Sinis16/Atlas/Tesis Electronica.xlsx

Sheet: BI Timeline
Task | Completion | Detailed task | Beginning week | End week | Perc | perc
Component investigation | 100.00 | 1.1 Processor | 2025-01-13 | 2025-01-20 | 100%
Component investigation | 100.00 | 1.2 PMIC (Power management) | 2025-01-13 | 2025-01-20 | 100%
Component investigation | 100.00 | 1.3 UWB Component | 2025-01-13 | 2025-01-20 | 100%
Component investigation | 100.00 | 1.4Wireless Charging Component | 2025-01-13 | 2025-01-20 | 100%
Component investigation | 100.00 | 1.5 NFC Component | 2025-01-13 | 2025-01-20 | 100%
Technology investigation | 100.00 | 2.1 Firmware to use | 2025-01-13 | 2025-01-20 | 100%
Technology investigation | 100.00 | 2.2 Bluetooth Signal Receiving | 2025-01-20 | 2025-02-03 | 100%
Technology investigation | 100.00 | 2.3 Bluetooth programming | 2025-01-27 | 2025-02-17 | 100%
Technology investigation | 100.00 | 2.4 Bluetooth Antenna | 2025-01-13 | 2025-02-17 | 100%
Technology investigation | 100.00 | 2.5 UWB Signal Receiving | 2025-01-20 | 2025-02-03 | 100%
Technology investigation | 100.00 | 2.6 UWB programming | 2025-01-27 | 2025-02-17 | 100%
Technology investigation | 100.00 | 2.7 UWB Antenna | 2025-01-13 | 2025-02-03 | 40%
Technology investigation | 100.00 | 2.8 Wireless Charging Programming | 2025-01-27 | 2025-02-17 | 40%
Technology investigation | 100.00 | 2.9 Wireless Charging Antenna | 2025-01-13 | 2025-02-03 | 40%
Technology investigation | 100.00 | 2.10 NFC Signal Receiving | 2025-01-20 | 2025-02-03 | 40%
Technology investigation | 100.00 | 2.11 NFC Programming | 2025-01-27 | 2025-02-17 | 0%
Technology investigation | 100.00 | 2.12 NFC Antenna | 2025-01-13 | 2025-02-03 | 0%
Application investigation | 0.00 | 3.1 Software to make | 2025-02-10 | 2025-03-03 | 0%
Application investigation | 0.00 | 3.2 Database to use | 2025-02-17 | 2025-03-10 | 0%
Application investigation | 0.00 | 3.3 Data to store | 2025-02-17 | 2025-03-10 | 0%
Application investigation | 0.00 | 3.4 UI to elaborate | 2025-02-24 | 2025-03-17 | 0%
Technology exploration | 0.00 | 4.1 Processor module | 2025-02-10 | 2025-03-10 | 0%
Technology exploration | 0.00 | 4.2 Processor module + App | 2025-03-31 | 2025-04-21 | 0%
Technology exploration | 0.00 | 4.3 Processor module + Bluetooth | 2025-02-17 | 2025-02-24 | 0%
Technology exploration | 0.00 | 4.4 Processor module + UWB | 2025-02-24 | 2025-03-03 | 0%
Technology exploration | 0.00 | 4.5 Processor module + NFC | 2025-03-03 | 2025-03-10 | 0%
Technology exploration | 0.00 | 4.6 Processor module + Wireles Charging | 2025-03-10 | 2025-03-17 | 0%
Antenna design | 0.00 | 5.1 Bluetooth PCB Design | 2025-03-17 | 2025-03-24 | 0%
Antenna design | 0.00 | 5.2 UWB PCB Design | 2025-03-17 | 2025-03-24 | 0%
Antenna design | 0.00 | 5.3 NFC / Wireless charging Design | 2025-03-17 | 2025-03-24 | 0%
PCB design | 0.00 | 6.1 Processor and complementary passive | 2025-03-24 | 2025-04-07 | 0%
PCB design | 0.00 | 6.2 PMIC (Power management) | 2025-03-31 | 2025-04-14 | 0%
PCB design | 0.00 | 6.3 Wireless Charging | 2025-04-07 | 2025-04-14 | 0%
PCB design | 0.00 | 6.4 Application Design | 2025-02-17 | 2025-03-10 | 0%
PCB design | 0.00 | 6.5 Application Implementation | 2025-03-17 | 2025-05-12 | 0%
PCB trials | 0.00 | 6.1 Processor functionality | 2025-04-21 | 2025-05-12 | 0%
PCB trials | 0.00 | 6.2 Bluetooth functionality | 2025-04-21 | 2025-05-12 | 0%
PCB trials | 0.00 | 6.3 Bluetooth Specs | 2025-05-19 | 2025-05-26 | 0%
PCB trials | 0.00 | 6.4 UWB functionality | 2025-04-21 | 2025-05-12 | 0%
PCB trials | 0.00 | 6.5 UWB Specs | 2025-05-19 | 2025-05-26 | 0%
PCB trials | 0.00 | 6.6 Wireless Charging Functionality | 2025-04-21 | 2025-05-12 | 0%
PCB trials | 0.00 | 6.7 NFC Functionality | 2025-04-21 | 2025-05-12 | 0%
Documentation | 0.00 | 7.1 Document | 2025-01-27 | 2025-05-26 | 0%

Sheet: Timeline
Time |  | Mes | noviembre | noviembre | noviembre | noviembre | diciembre | diciembre | diciembre | diciembre | diciembre | enero | enero | enero | enero | febrero | febrero | febrero | febrero | marzo | marzo | marzo | marzo | marzo | abril | abril | abril | abril | mayo | mayo | mayo | mayo
 |  | Semana | 2024-11-04 | 2024-11-11 | 2024-11-18 | 2024-11-25 | 2024-12-02 | 2024-12-09 | 2024-12-16 | 2024-12-23 | 2024-12-30 | 2025-01-06 | 2025-01-13 | 2025-01-20 | 2025-01-27 | 2025-02-03 | 2025-02-10 | 2025-02-17 | 2025-02-24 | 2025-03-03 | 2025-03-10 | 2025-03-17 | 2025-03-24 | 2025-03-31 | 2025-04-07 | 2025-04-14 | 2025-04-21 | 2025-04-28 | 2025-05-05 | 2025-05-12 | 2025-05-19 | 2025-05-26
Period | Component investigation | Processor |  | Done
 |  | PMIC (Power management) |  | Done
 |  | UWB Component |  | Done
 |  | Wireless Charging Component |  | Done
 |  | NFC Component |  | Done
 | Technology investigation | Firmware to use
 |  | Bluetooth Signal Receiving |  |  | Bluetooth Signal Receiving
 |  | Bluetooth programming |  |  |  | Bluetooth programming
 |  | Bluetooth Antenna
 |  | UWB Signal Receiving |  |  | UWB Signal Receiving
 |  | UWB programming |  |  |  | UWB programming
 |  | UWB Antenna
 |  | Wireless Charging Programming |  |  |  | Wireless Charging Programming
 |  | Wireless Charging Antenna
 |  | NFC Signal Receiving |  |  | NFC Signal Receiving
 |  | NFC Programming |  |  |  | NFC Programming
 |  | NFC Antenna
 | Application investigation | Software to make |  |  |  |  |  |  |  | Software to make
 |  | Database to use |  |  |  |  |  |  |  |  | Database to use
 |  | Data to store |  |  |  |  |  |  |  |  | Data to store
 |  | UI to elaborate |  |  |  |  |  |  |  |  |  | UI to elaborate
 | Technology exploration | Processor module |  |  |  |  |  |  | Processor module
 |  | Processor module + App |  |  |  |  |  |  |  |  |  |  |  |  |  |  | Processor module + App
 |  | Processor module + Bluetooth |  |  |  |  |  |  |  |  | Processor module + Bluetooth
 |  | Processor module + UWB |  |  |  |  |  |  |  |  |  |  | Processor module + UWB
 |  | Processor module + NFC |  |  |  |  |  |  |  |  |  |  |  |  | Processor module + NFC
 |  | Processor module + Wireles Charging |  |  |  |  |  |  |  |  |  |  |  |  | Processor module + Wireles Charging
 | Antenna design | Bluetooth PCB Design |  |  |  |  |  |  |  |  |  |  |  |  |  | Bluetooth PCB Design
 |  | UWB PCB Design |  |  |  |  |  |  |  |  |  |  |  |  |  | UWB PCB Design
 |  | NFC / Wireless charging Design |  |  |  |  |  |  |  |  |  |  |  |  |  | NFC / Wireless charging Design
 | PCB design | Processor and complementary passive |  |  |  |  |  |  |  |  |  |  |  |  |  |  | Processor and complementary passive
 |  | PMIC (Power management) |  |  |  |  |  |  |  |  |  |  |  |  |  |  |  | PMIC (Power management)
 |  | Wireless Charging |  |  |  |  |  |  |  |  |  |  |  |  |  |  |  |  | Wireless Charging
 |  | Application Design |  |  |  |  |  |  |  |  |  | Application Design
 |  | Application Implementation |  |  |  |  |  |  |  |  |  |  |  |  | Application Implementation
 | PCB trials | Processor functionality |  |  |  |  |  |  |  |  |  |  |  |  |  |  |  |  |  |  | Processor functionality
 |  | Bluetooth functionality |  |  |  |  |  |  |  |  |  |  |  |  |  |  |  |  |  |  | Bluetooth functionality
 |  | Bluetooth Specs |  |  |  |  |  |  |  |  |  |  |  |  |  |  |  |  |  |  | Bluetooth Specs |  |  | Bluetooth Specs
 |  | UWB functionality |  |  |  |  |  |  |  |  |  |  |  |  |  |  |  |  |  |  | UWB functionality
 |  | UWB Specs |  |  |  |  |  |  |  |  |  |  |  |  |  |  |  |  |  |  | UWB Specs |  |  | UWB Specs
 |  | Wireless Charging Functionality |  |  |  |  |  |  |  |  |  |  |  |  |  |  |  |  |  |  | Wireless Charging Functionality
 |  | NFC Functionality |  |  |  |  |  |  |  |  |  |  |  |  |  |  |  |  |  |  | NFC Functionality
 | Documentation | Proposal
 |  |  | 1 | 2 | 3
Time |  | % Completado | Mes | enero | enero | enero | febrero | febrero | febrero | febrero | marzo | marzo | marzo | marzo | marzo | abril | abril | abril | abril | mayo | mayo | mayo | mayo
 |  |  | Semana | 2025-01-13 | 2025-01-20 | 2025-01-27 | 2025-02-03 | 2025-02-10 | 2025-02-17 | 2025-02-24 | 2025-03-03 | 2025-03-10 | 2025-03-17 | 2025-03-24 | 2025-03-31 | 2025-04-07 | 2025-04-14 | 2025-04-21 | 2025-04-28 | 2025-05-05 | 2025-05-12 | 2025-05-19 | 2025-05-26
Period | Component investigation | 100% | Processor |  | Done
 |  | 100% | PMIC (Power management) |  | Done
 |  | 100% | UWB Component |  | Done
 |  | 100% | Wireless Charging Component |  | Done
 |  | 100% | NFC Component |  | Done
 | Technology investigation | 100% | Firmware to use |  |  | Firmware to use
 |  | 40% | Bluetooth Signal Receiving |  | Bluetooth Signal Receiving
 |  | 30% | Bluetooth programming |  |  | Bluetooth programming
 |  | 0% | Bluetooth Antenna
 |  | 10% | UWB Signal Receiving |  | UWB Signal Receiving
 |  | 10% | UWB programming |  |  | UWB programming
 |  | 20% | UWB Antenna
 |  | 20% | Wireless Charging Programming |  |  | Wireless Charging Programming
 |  | 20% | Wireless Charging Antenna
 |  | 0% | NFC Signal Receiving |  | NFC Signal Receiving
 |  | 0% | NFC Programming |  |  | NFC Programming
 |  | 0% | NFC Antenna
 | Application investigation | 0% | Software to make |  |  |  |  | Software to make
 |  | 0% | Database to use |  |  |  |  |  | Database to use
 |  | 0% | Data to store |  |  |  |  |  | Data to store
 |  | 0% | UI to elaborate |  |  |  |  |  |  | UI to elaborate
 | Technology exploration | 0% | Processor module |  |  |  |  | Processor module
 |  | 0% | Processor module + App |  |  |  |  |  |  |  |  |  |  |  | Processor module + App
 |  | 0% | Processor module + Bluetooth |  |  |  |  |  | Processor module + Bluetooth
 |  | 0% | Processor module + UWB |  |  |  |  |  |  | Processor module + UWB
 |  | 0% | Processor module + NFC |  |  |  |  |  |  |  |  | Processor module + NFC
 |  | 0% | Processor module + Wireles Charging |  |  |  |  |  |  |  |  | Processor module + Wireles Charging
 | Antenna design | 0% | Bluetooth PCB Design |  |  |  |  |  |  |  |  |  | Bluetooth PCB Design
 |  | 0% | UWB PCB Design |  |  |  |  |  |  |  |  |  | UWB PCB Design
 |  | 0% | NFC / Wireless charging Design |  |  |  |  |  |  |  |  |  | NFC / Wireless charging Design
 | PCB design | 20% | Processor and complementary passive |  |  |  |  |  |  |  |  |  |  | Processor and complementary passive
 |  | 40% | PMIC (Power management) |  |  |  |  |  |  |  |  |  |  |  | PMIC (Power management)
 |  | 40% | Wireless Charging |  |  |  |  |  |  |  |  |  |  |  |  | Wireless Charging
 |  | 0% | Application Design |  |  |  |  |  | Application Design
 |  | 0% | Application Implementation |  |  |  |  |  |  |  |  | Application Implementation
 | PCB trials | 0% | Processor functionality |  |  |  |  |  |  |  |  |  |  |  |  |  |  | Processor functionality
 |  | 0% | Bluetooth functionality |  |  |  |  |  |  |  |  |  |  |  |  |  |  | Bluetooth functionality
 |  | 0% | Bluetooth Specs |  |  |  |  |  |  |  |  |  |  |  |  |  |  |  |  |  |  | Bluetooth Specs
 |  | 0% | UWB functionality |  |  |  |  |  |  |  |  |  |  |  |  |  |  | UWB functionality
 |  | 0% | UWB Specs |  |  |  |  |  |  |  |  |  |  |  |  |  |  |  |  |  |  | UWB Specs
 |  | 0% | Wireless Charging Functionality |  |  |  |  |  |  |  |  |  |  |  |  |  |  | Wireless Charging Functionality
 |  | 0% | NFC Functionality |  |  |  |  |  |  |  |  |  |  |  |  |  |  | NFC Functionality
 | Documentation | 5% | Document

Sheet: State of the art
N/E: No Existe | N/C: No Conocido | N/I: No identificado | N/A: No Aplica |  |  |  |  |  |  | Antenna |  |  | Protocol versions |  |  |  |  |  |  |  |  |  | Sources
 | Components |  |  |  |  |  |  |  |  | Bluetooth | UWB | NFC | Bluetooth |  | UWB |  | NFC
Product | Processor | UWB IC | Flash memory | Accelerometer | Audio amplifier | DC-DC buck converter | Integrated load switch | NFC IC | Battery |  |  |  | Bluetooth version | Find my | UWB version | # of UWB antenna | Peripheral | Type
Airtag | Nordic nRF52832 | Apple U1 | GigaDevice GD25LE32D 32 Mbit | Bosch BMA280 | MAX98357AEWL | TI TPS6274 | ON Semiconductor FPF2487 | N/E | CR2032 | 2.4GHz | 6.5-8GHz | 13.65MHz | BLE 5.2 | BLE broadcasting | BPSK | 1 antenna | NFC-A | MIFARE Plus (Type 4) in Read-Only Mode |  |  |  |  | https://www.techinsights.com/blog/apple-airtag-teardown | https://adamcatley.com/AirTag.html | https://colinoflynn.com/2021/05/apple-airtag-teardown-test-point-mapping/ | https://es.ifixit.com/News/50681/desmontaje-de-airtag-si-esto-rastrea | https://www.refindcommerce.com/blogs/news/understanding-apples-find-my-network-and-how-trackers-operate-within-it
Smart tag 2 | Atomsic's ATM3325-5LCAQK-SR | NXP SR040 | N/C | N/C | N/C | N/C | N/C | N/I | CR2032 | 2.4GHz | 6.0-8.5GHz | 13.65MHz | BLE 5.3 | - | BPSK o HPRF | 1 antenna | N/I | N/I |  |  |  |  | https://technotrend.substack.com/p/samsung-galaxy-smarttag2-teardown | https://www.sammobile.com/news/smartthings-over-20-million-users-korea/ | https://fccid.io/A3LEIT5600/Internal-Photos/Internal-Photos-6686144 | https://www.manual.ec/samsung/smart-tag-2/manual?p=8
Chipolo One | Nordic nRF51822 | N/E |  |  | PAM8904 |  |  |  | CR2032 | 2.4GHz | N/E | N/E | BLE 4.0 | - | N/E | N/E |  |  |  |  |  |  | https://shkspr.mobi/blog/2016/11/inside-a-chipolo-plus/
Tile Slim | Nordic nRF52810 |  |  |  | MAS6240 |  |  |  | LiPo 3.0V, 380 mAh | 2.4GHz | N/E | N/E | BLE 5.2 |  | N/E | N/E |  |  |  |  |  |  | https://www.edn.com/examining-an-environmental-antonym-tiles-slim/#google_vignette
Pebblebee Clip |  |  |  |  |  | MP8904 |  |  | Li-ion | 2.4GHz | N/E | N/E | BLE 5.2 |  | N/E | N/E
Tile Mate | Nordic nRF52810 | N/E |  |  | MAS6240 |  |  | N/E | CR2032 | 2.4 GHz | N/E | N/E | BLE 5.2 |  | N/E | N/E | N/E | N/E |  |  |  |  | https://www.edn.com/teardown-tile-mate-bluetooth-tracker-relies-on-software/ | https://pallavaggarwal.in/2023/04/03/teardown-of-tile-mate-bluetooth-tracker/ | https://www.youtube.com/watch?v=oJi1fj6qtIk
Tile Sticker | Nordic nRF52810 |  |  |  |  |  |  |  |  |  |  |  |  |  |  |  |  |  |  |  |  |  | https://es.ifixit.com/Desmontaje/Tile+Sticker+Teardown/146491
 |  |  |  |  |  |  |  |  |  |  |  |  |  |  |  |  |  |  |  |  |  |  |  |  |  |  |  |  |  |  |  |  |  |  |  |  |  |  |  |  |  |  |  |  |  |  |  |  |  |  |  |  | Hardware |  |  | Software |  |  | Physical
 |  |  |  |  |  |  |  |  |  |  |  |  |  |  |  |  |  |  |  |  |  |  |  |  |  |  |  |  |  |  |  |  |  |  |  |  |  |  |  |  | N/C: No Conocido | N/I: No identificado | N/A: No Aplica |  |  |  |  |  |  | Antenna |  |  | Protocol versions
 | Size |  |  |  | Environment resistance | Speaker | Speakler dB | Ringtone personalization | Battery | Battery life | System Recquierements | Operating temperature |  | UWB position tracking | Maximum distance BLE | Maximum distance UWB | Distance Precision UWB | Angle Precision UWB | Bluetooth | NFC lost mode | Pairing mode | Button | SOS function | Accelerometer wakeup function | Find My Network | Always-at-home scanner | Software name assigning | Share tracker location | Unwanted tracking detection | Power saving mode | Included hole | Special case | Wireless charging | USB port | AR finding | Location history | Left behind | SOS button | Light indicator | Cost | Components |  |  |  |  |  |  |  |  | Bluetooth | UWB | NFC | Bluetooth |  | UWB |  | NFC
Product components | Measurement 1 | Measurement 2 | Measurement 3 | Weight |  |  |  |  |  |  |  | Minimum | Maximum |  |  |  |  |  |  |  |  |  |  |  |  |  |  |  |  |  |  |  |  |  |  |  |  |  |  |  | Processor | UWB IC | Flash memory | Accelerometer | Audio amplifier | DC-DC buck converter | Integrated load switch | NFC IC | Battery |  |  |  | Bluetooth version | Find my | UWB version | # of UWB antenna | Peripheral | Type
Airtag | Diameter: 31.9mm | N/A | Depth: 8.0mm | 11.00 g | IP67 | Built-in speaker | 73 dB | Not included | Replaceable Coin cell | 1 year | Apple Account, iOS 14.5 or higher, iPhone 11 or newer | -20C | 60C | Included | Around 100m (BLE) | Around 10m | Around 10cm | Not disclosed | BLE 5.2 | Included | NFC | Not Included | Not Included | Included | Apple's | Not Included | Included | Included | Included | Not included | Not included | N/A | Not included | Not included | Included | Not Included | Included | Not Included | Not Included | 29 USD | Nordic nRF52832 | Apple U1 | GigaDevice GD25LE32D 32 Mbit | Bosch BMA280 | MAX98357AEWL | TI TPS6274 | ON Semiconductor FPF2487 | N/E | CR2032 | 2.4GHz | 6.5-8GHz | 13.65MHz | BLE 5.2 | BLE broadcasting | BPSK | 1 antenna | NFC-A | MIFARE Plus (Type 4) in Read-Only Mode
Smart tag 2 | Width: 28.8mm | Height: 52.44mm | Depth: 8.0mm | 13.75 g | IP67 | Built-in speaker | 65 dB | Included | Replaceable Coin cell | 500 days | Galaxy hardware with OS 9 or higher, UWB enabled, SmartThings | -15C | 35C | Included | Up to 120m (BLE) | Around15m | Around 10cm | +- 10 degrees | BLE 5.3 | Included | Bluetooth | Included | Not Included | Not Included | Samsung's | Included | Included | Included | Included | Included | Included | N/A | Not included | Not included | Included | Included | Included | Not Included | Not Included | 29 USD | Atomsic's ATM3325-5LCAQK-SR | NXP SR040 | N/C | N/C | N/C | N/C | N/C | N/I | CR2032 | 2.4GHz | 6.0-8.5GHz | 13.65MHz | BLE 5.3 | - | BPSK o HPRF | 1 antenna | N/I | N/I
Chipolo One | Diameter: 31.9mm | N/A | Depth: 6.4mm | 8.00 g | IPX5 | Built-in speaker | 120 dB | Not included | Replaceable Coin cell | 2 years | iOS 14 or higher, ios 9 or higher | -15C | 60C | Not Included | Up to 60m | N/A | N/A | N/A | BLE 4.0 | N/A | Bluetooth | Included | Not Included | Not included | Not Included | Not included | Included | Included | Not Included | Not included | Included | N/A | Not included | Not included | Not Included | Not Included | Included | Not Included | Not Included | 25 USD | Nordic nRF51822 | N/E |  |  | PAM8904 |  |  |  | CR2032 | 2.4GHz | N/E | N/E | BLE 4.0 | - | N/E | N/E
Tile Slim | Width: 85.4mm | Height: 53.9mm | Depth: 2.5mm | 13.88 g | IP68 | Buzzer | 104 dB | Not included | Non replaceable LiPo | 3 years | Life360, iOS, Android | -10C | 60C | Not Included | Up to 105 m | N/A | N/A | N/A | BLE 5.2 | N/A | Bluetooth | Included | Included | Not included | Tile's | Not included | Included | Subscription | Not Included | Not Included | Not included | Card shape | Not included | Not included | Not Included | Subscription | Included | Included | Not Included | 30 USD | Nordic nRF52810 |  |  |  | MAS6240 |  |  |  | LiPo 3.0V, 380 mAh | 2.4GHz | N/E | N/E | BLE 5.2 |  | N/E | N/E
Pebblebee Clip | Width: 45mm | Height: 38mm | Depth: 8.5mm | 8g | IPX6 | Buzzer | 100 dB | Included | Rechargeable Li-ion | 1 year per charge | Pebblebee app, iOS, Android | -15C | 43C | Not Included | Around 100m (BLE) | N/A | N/A | N/A | BLE 4.0> | N/A | Bluetooth | Included | Not Included | Not included | Google's, Apple's | Not included | Included | Included | Not Included | Not Included | Included | N/A | Not included | USB-C | Not Included | Not Included | Included | Not Included | Included | 35 USD |  |  |  |  |  | MP8904 |  |  | Li-ion | 2.4GHz | N/E | N/E | BLE 5.2 |  | N/E | N/E
Tile Mate | Width: 37.6mm | Height: 37.6mm | Depth: 7.4mm | 8g | IP68 | Built-in speaker | 100 dB | Not included | Non replaceable LiPo | 3 years | Life360, iOS, Android | -10C | 60C | Not Included | Up to 105 m | N/A | N/A | N/A | BLE 5.2 | N/A | Bluetooth | Included | Included | Not included | Tile's | Not included | Included | Subscription | Not Included | Not Included | Included | N/A | Not included | Not included | Not Included | Subscription | Included | Included | Not Included | 28 USD | Nordic nRF52810 | N/E |  |  | MAS6240 |  |  | N/E | CR2032 | 2.4 GHz | N/E | N/E | BLE 5.2 |  | N/E | N/E | N/E | N/E
Tile Sticker | Width: 28.2mm | Height: 28.2mm | Depth: 7.4mm | 6g | IP67 | Buzzer | 100 dB | Not included | Non replaceable LiPo | 3 years | Life360, iOS, Android | -10C | 60C | Not Included | Up to 75m | N/A | N/A | N/A | BLE 5.2 | N/A | Bluetooth | Included | Included | Not included | Tile's | Not included | Included | Subscription | Not Included | Not Included | Not included | Adhesive | Not included | Not included | Not Included | Subscription | Included | Included | Not Included | 25 USD
Sinis emissor | Width: 85.4mm | Height: 53.9mm | Depth: 2.5mm | 8g | IP67 | Built-in speaker | 120 dB | Included | Rechargeable Li-ion | 3 years | iOS 14 or higher, ios 9 or higher | -10C | 60C | Included | Up to 120m (BLE) | Around15m | Around 10cm | +- 10 degrees | BLE 5.4 | Included | NFC | Included | Included | Included | Google's, Apple's | Kind of | Included | Included | Included | Included | Not included | Card shape / Adhesive | Included | USB-C | Not Included | Included | Included | Included | Included | 15 USD | Nordic nRF52833 | DW3320 | N/C | Bosch BMA400 | PAM8904 | nPM1100 | Maybe? | N/E | LiPo 3.0V, 380 mAh | 2.4 GHz | 6.0-8.5GHz | 13.65MHz | BLE 5.4 | - | BPSK | 2 antenna | NFC-A
Sinis receiver | Width: 37.6mm | Height: 37.6mm | Depth: 7.4mm | 13.88 g | IP67 | Built-in speaker | 120 dB | Included | Rechargeable Li-ion | 3 years | iOS 14 or higher, ios 9 or higher | -10C | 60C | Included | Up to 120m (BLE) | Around15m | Around 10cm | +- 10 degrees | BLE 5.4 | Included | NFC | Included | Included | Included | Google's, Apple's | Kind of | Included | Included | Included | Included | Incuded | N/A or Adhesive | Included | USB-C | Not Included | Included | Included | Included | Included | 15 USD | Nordic nRF52833 | DW3320 | N/C | Bosch BMA400 | PAM8904 | nPM1100 | Maybe? | N/E | LiPo 3.0V, 380 mAh | 2.4 GHz | 6.0-8.5GHz | 13.65MHz | BLE 5.4 | - | BPSK | 1 antenna | NFC-A | MIFARE Plus (Type 4) in Read-Only Mode
Estándar | Year introduced
IEEE 802.15.4z | 2020
FCC RF Exposure Information |  |  |  |  |  |  |  |  |  |  |  |  |  |  |  |  |  |  |  |  |  |  |  |  |  |  |  |  |  |  |  |  |  |  |  | 0
 |  |  |  |  | Series1
Hardware | Sound | Buzzers | IEC 60268-2 | Electro mechanical transducers standards | 18
Hardware | Sound | Speakers | IEC 60268-5 | Loudspeakers standards | 18
Hardware | Battery | Coin cells | IEC 60086 | Performance and testing | 18
Hardware | Battery | LiPo & Li-Ion | IEC 62133 | Performance and safety requirements | 18
Hardware | Battery | LiPo & Li-Ion | UL 2054 | Performance and safety testing | 18
Hardware | Battery | Wireless Power Transfer | WPC Qi Standard | Wireless charging metrics and safety | 18
Hardware | Communications | UWB | IEEE 802.15.4z | Enhanced UWB Positioning | 18
Hardware | Communications | UWB | ISO/IEC 18305 | Position system metrics / tests | 18
Hardware | Communications | BLE | ISO/IEC 24730-2 | RTLS | 18
Hardware | Communications | BLE | IEEE 802.15.1 | BLE standard | 18
Hardware | Communications | BLE | Bluetooth SIG | Updated BLE Standards | 18
Hardware | Communications | BLE | - | Unwanted tracking detection | 18
Hardware | Communications | NFC | ISO/IEC 14443 | Proximity Cards | 18
Hardware | Communications | NFC | ISO/IEC 18092 | Interface and Protocol | 18
Hardware | Communications | NFC | - | Lost mode | 18
Hardware | Movement | Accelerometer | - | Movement wake-up | 18
Hardware | USB | US Type-C | USB Type-C Specifications | Power and data transfer | 18
Software | UI | Human-Computer interaction | ISO9241 | Ergonomics | 18
Software | Shared assets | Shared tracking |  |  | 18
Software | Battery consumption | Battery saver |  |  | 18
Software | Mesh network tracking | Find my networks | - | Apple's Find my, SmartThings, Google's Find My | 18
Software | Visual tracking | Augmented Reality tracking |  |  | 18
Software | Multifunctional purpose | Programmable button | - | Programmable function, SOS, device locating | 18
Software | Location data | Location history |  |  | 18
Mechanical | Ingress Protection | IP ratings | IEC 60529 | Degree of protection | 18
Mechanical | Case design | Physical dimensions and tolerances | ISO 1101 | Geometrical Product Specifications | 18
Mechanical | Case design | Portability | - | Keyring design | 18
Mechanical | Case design | Practicality | - | Card shape / Adhesive | 18
Mechanical | Environmental conditions | Temperature ranges | IEC 60721-3 | Indoor/Outdoor capabilities | 18
Mechanical | Device detection | Visual indicators | IEC 60073 | Human Machine Interfacing | 18

Sheet: Processors
Brand | Processor | Bluetooth | Transmit mode (Tx) | Receive mode (Rx) | Output power range (dBm) | Sensitivity (dBm) | Clock rate (MHz) | Flash Memory (kB) | RAM Memory (kB) | Operating Voltage (V) | Native NFC | Cost |  | IDE
Minimum |  | 5.0 | 5 mA / 15mA | 5mA / 7mA | -20dBm / 4dBm | -95dBm / -100dBm | 16MHz | 256kB | 64kB |  | No | Low
Recommended |  | 5.1 | 5 mA / 15mA | 5mA / 7mA | -20dBm / 4dBm | -95dBm / -100dBm | 64MHz | 512kB | 128kB |  | Yes | Lower
Nordic Semiconductor | nRF52833 | 5.4 | 4.9mA | 4.6mA | -20dBm / 8dBm | -96dBm | 64MHz | 512kB | 128kB | 1.7V - 3.6V | Yes | $3.59 | $2.35 | Microsoft Visual Studio Code (https://code.visualstudio.com/) |  | Interesting
 | nRF52820 | 5.3 | 6mA | 4.7mA | -20dBm / 8dBm | -95dBm | 64MHz | 256kB | 32kB | 1.7V - 3.6V | No | $2.64 | $1.70
Renesas | DA14535MOD | 5.3 | 2.6 mA, 3.6mA | 2.6mA, 2.7mA | -18, -3, 3 | -92.5dBm | 16MHz | 128, 1000 | 64kB | 1.8V - 3.3V | No | $6.22
 | RX23W | 5.0 | 4.3mA | 3mA | 4 | -95dBm | 54MHz | 384, 512 | 64kB | 2.7V - 3.6V | No | $4.83 | $2.95 | e² studio IDE (https://www.renesas.com/us/en/software-tool/e-studio)
Texas Instruments | CC2674R10 | 5.0 | 6.4mA | 7.3mA | 10dBm | -105dBm | 48MHz | 1024kB | 256kB | 1.8V - 3.8V | Yes | $8.23 | $4.42
 | CC2642R | 5.2 | 7.0mA | 6.9mA | 5dBm | -105dBm | 48MHz | 352kB | 80kB | 1.8V - 3.8V | No | $2.66 | $1.61
STMicroelectronics | STM32WB55 | 5.4 | 5.2mA | 4.5mA | -20dBm / 8dBm | -100dBm | 64MHz | 1024KB | 256Kb | 1.71V - 3.6V | No | $3.66 | $2.43
Silicon Labs | EFR32BG27 | 5.4 | 4.1mA | 3.6mA | 8dBm | -106.9dBm | 76.8MHz | 768kB | 64kB | 1.8V - 3.8V | No | $4.15 | $2.16 | Silicon Labs Simplicity Studio IDE (https://www.silabs.com/developers/simplicity-studio) |  | Interesting
Infineon | CYW20822 | 5 | 3mA | 1.3mA | 4dBm | -101dBm | 16MHz | 1024kB | 128kB | 1.71V - 3.6V | No | $4.25 | $3.99 |  |  | Interesting
Onsemi | RSL10 | 5.2 | 8.9mA | 5.6mA | -17dBm / 6dBm | -94dBm | 48MHz | 384KbB | 76kB | 1.1V - 3.6V | No | $3.90 | $3.36
Telink | TLSR9218BER | 5.2 | 6.6mA | 6.1mA | -24dBm / 10dBm | -95.5dBm | 16MHz | 2048kB | 256kB | 1.8V - 3.3V | No | $6.55 | $3.29 |  | Apple Homekit
 | TLSR9218AER | 5.3 | 6.6mA | 6.1mA | -24dBm / 10dBm | -95.5dBm | 16MHz | 1024kB | 256kB | 1.8V - 3.3V | No | $5.61 | $2.82 | IDE for TLSR9 series chips (http://wiki.telink-semi.cn/wiki/IDE-and-Tools/RISC-V_IDE_for_TLSR9_Chips/) | Apple Homekit | Mas relajao
 | nRF52833 | 5.1 | 4.9mA | 4.6mA | -20dBm / 8dBm | -96dBm | 64MHz | 512kB | 128kB | 1.7V - 3.6V | Yes | $3.59 | $2.35
 |  |  |  |  | 8dB

Sheet: UWB
 | Supply Voltage (V) | Current (A) | RX Current (mA) | TX Current (mA) | Distance precision (cm) | Angle precision (deg) | Frecuency range | Protocol | # de Antenas | Cost
DW1000 | 2.8V - 3.6V | 12mA / 4mA / 1uA / 50nA | 30mA | 70 mA | 10cm | NaN | 324MHz - 6999MHz | IEEE802.15.4-2011 UWB | 1 | $9.63 | $4.55
DW3210 | 2.4V - 3.6V | 16mA / 4mA / 810nA / 210nA | 47mA - 107mA | 32mA - 76mA | 6cm | 12.5 | 6489.6 MHz | IEEE 802.15.4-2020 UWB | 2 | $11.28 | $6.15
DW3220 | 2.4V - 3.6V | 32mA / 8mA / 850nA / 260nA | 74 mA | 40mA | 6cm | 10 | 6489.6 MHz | IEEE802.15.4-2015 UWB | 2 | $11.41 | $5.40
SR040 | 1.8V - 3.67V | 1mA / 10uA | 60mA - 90mA | 70 mA - 120mA | 10cm | Yes | 6240 MHz | IEEE 802.15.4z | 1 | - | -
SR150 | 1.71V - 1.98 V | 1mA / 10uA | 60mA - 90mA | 70 mA - 120mA | 10cm | 3 | 6240 MHz | IEEE802.15.4z | 3 | $24.40 | $13.61

Sheet: PMIC
 |  | Quiescent current | Chage current | Input voltage | Step down Voltage | Step down current | Battery operating input range | Cost ($) |  | Features
Nordic semiconductors | nPM1100 | 800 nA | 20mA - 400mA | 4.1V - 6.7V | 1.8V - 2.1V - 2.7V - 3.0V | 150mA | 2.3V - 4.35V | $2.21 | $1.09 | Ship mode isolates battery | Automatic USB port detection | No software control | LED driver | Automatic charging mode | 1
 | LTC3335 | 680nA | 5mA - 250mA | 1.8V-5.5V | 1.8V - 5.0V | 50mA |  | $10.75 | $5.27 | CARISIMO | Coulomb counter para descarga | I2C | Discharge alarm |  | 2
 | ADP160 | 560 nA |  | 2.2V - 5.5V | 1.2V - 4.2V | 150 mA |  | $3.36 | $1.76 | Adjustable output |  | Logic control |  |  | 1
 | TPS62740 |  |  |  |  |  |  | $1.50
 | MIC5365-3.3YC5-TR |  |  |  |  |  |  | $0.18

Sheet: Audio amplifier
 |  | Supply Voltage | Supply Current | Output Voltage | Output Power | Quiescent current (mA) | Load | Cost (USD)
Texas Instruments | TPA2016D2 | 2.5V - 5.5V | 3.7mA - 4.7mA |  | 2.8W | 50uA | 4 Ohm | $2.01 | $0.93
Diodes incorportated | PAM8904 | 1.88V - 5.5V | 7.9mA | 7.2V - 9V (x3) | 3.2W | 1700uA - 50uA | 4 Ohm | $0.52 | $0.31 | The one Chipolo uses
 | PAM8904Q | 2.3V - 5V | 8.5mA | 7.2V - 9V (x3) | 3.2W | 1700uA - 50uA | 4 Ohm | $0.88 | $0.35

Sheet: Wireless Charging
 |  | Quiescent power | Output power (W) | Output voltage (V) | Output current (mA) | Cost
Texas Instruments | BQ51013BRHLR | 20uA | 5 | 5 | 10 mA - 1000mA | $3.16 | $1.79 | QI compliance

Sheet: Accelerometer...
 |  | Supply voltage (V) | Supply current (uA) | Quiescent current (uA) | Acceleration Range(g) | Cost
Bosch | BMA400 | 1.2V - 3.6V | 800nA | 200nA | 2g - 16g | $3.01 | $1.42 | Buena
Analog Devices | ADXL362 | 1.6V - 3.5V | 13 uA | 270nA | 2g - 8g | $8.05 | $4.56 | Fino pero alto costo
STMElectronics | LIS2DW12 | 1.62V - 3.6V | 1 uA | 50nA | 2g - 16g | $2.30 | $0.89 | Buena
 | BMA280 |  |  |  |  |  |  | No disponible

Sheet: NFC
nRF52833 | 2
MFRC52202HN1
ST25R3911B | 1
PN7150

Sheet: Battery
Li-Ion |  | 3.7V | 500 - 1000mAh
Coin Cell | CR2032
 | 18650
Li-Po
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
