Sinis16/Atlas/symbolsFootprints/NPM1100-QDAB-R7.step

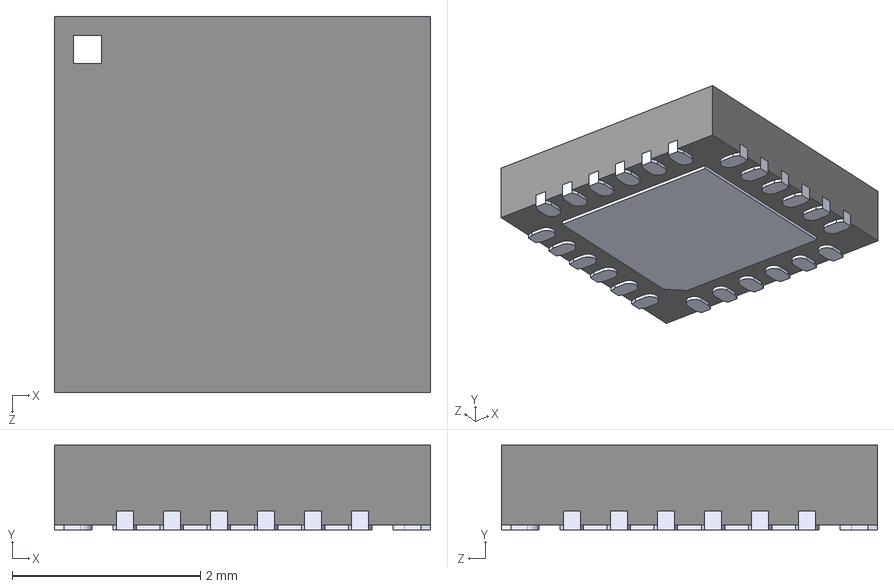
[picture p10: CAD file, 2025-03-27]
symbolsFootprints/NPM1100-QDAB-R7.step
4.00 x 0.9 x 4.00 mm
