Sinis16/Atlas/symbolsFootprints/B3U-1000P.step

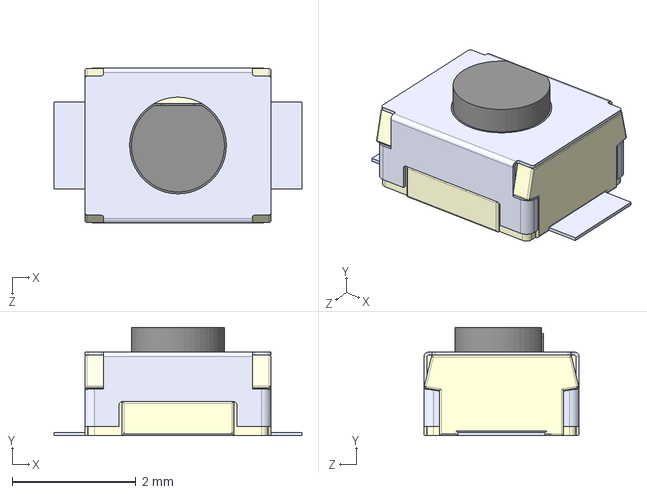
[picture p11: CAD file, 2025-03-27]
symbolsFootprints/B3U-1000P.step
4.00 x 1.75 x 2.50 mm
