Sinis16/Atlas/symbolsFootprints/ECS-384-10-33B-CKY-TR3.step

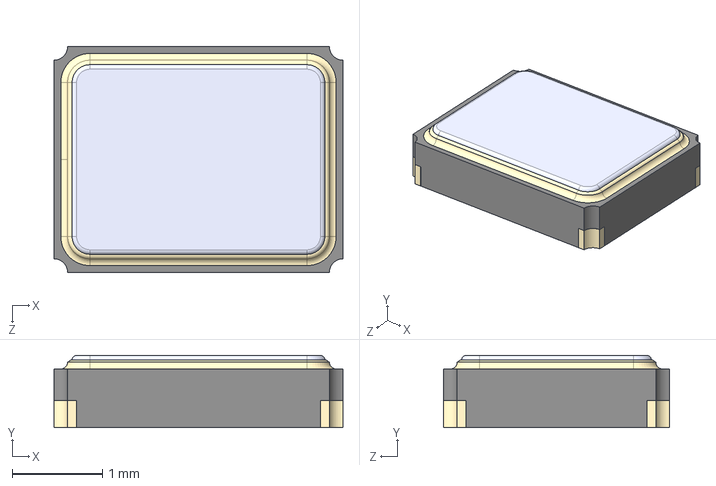
[picture p12: CAD file, 2025-03-27]
symbolsFootprints/ECS-384-10-33B-CKY-TR3.step
3.20 x 0.8 x 2.50 mm
