Sinis16/Atlas/symbolsFootprints/ECS-.327-9-12R-C-TR.step

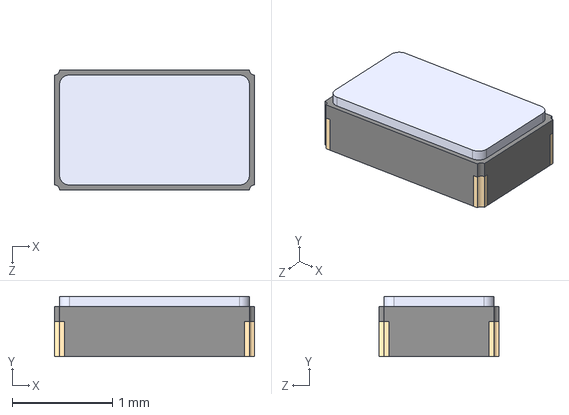
[picture p13: CAD file, 2025-03-27]
symbolsFootprints/ECS-.327-9-12R-C-TR.step
2.00 x 0.6 x 1.20 mm
