Sinis16/Atlas/symbolsFootprints/BMA400.step

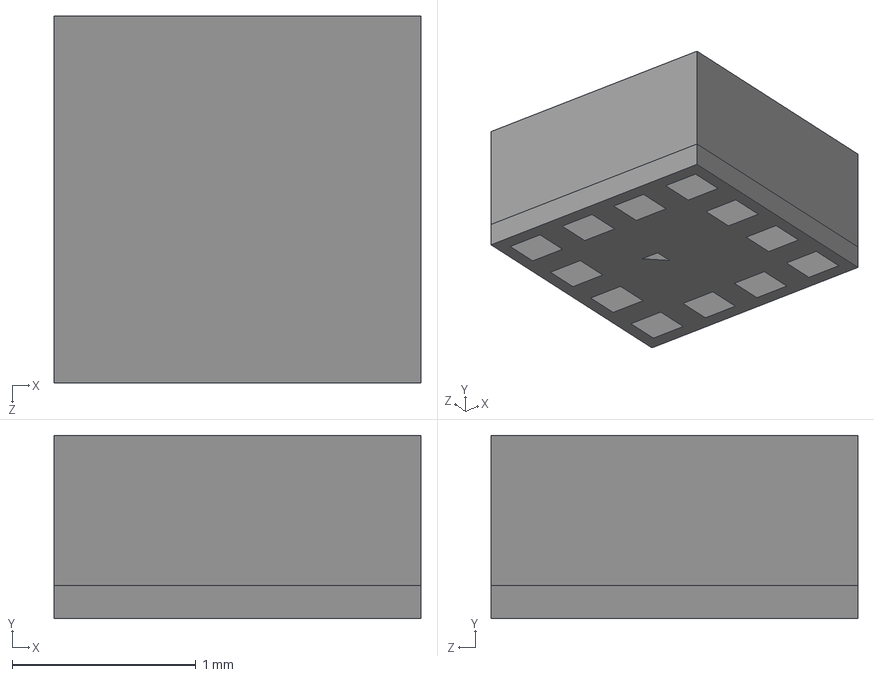
[picture p14: CAD file, 2025-03-27]
symbolsFootprints/BMA400.step
2.00 x 1.00 x 2.00 mm
