Sinis16/Atlas/symbolsFootprints/FDV303N.step

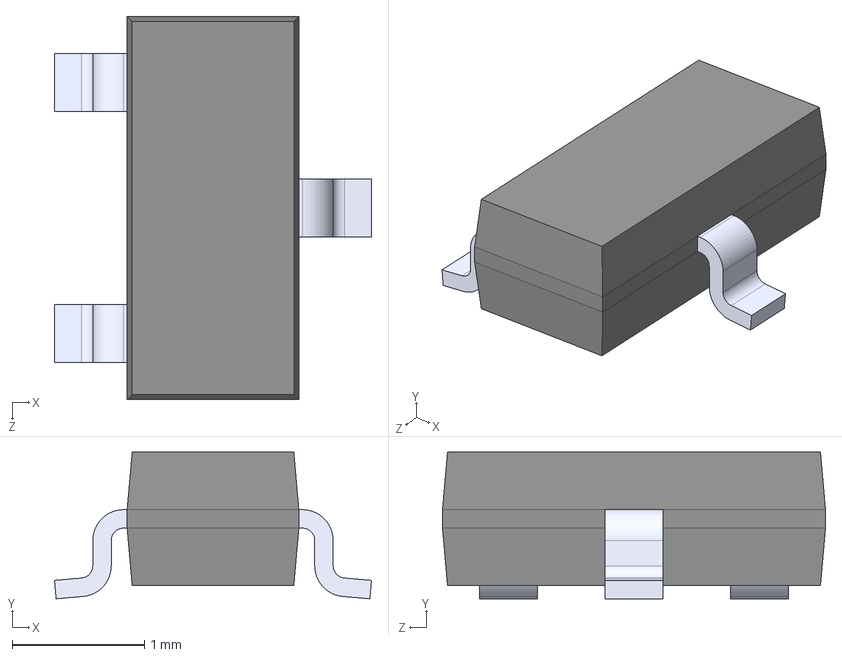
[picture p15: CAD file, 2025-03-27]
symbolsFootprints/FDV303N.step
2.40 x 1.11 x 2.90 mm
