Sinis16/Atlas/symbolsFootprints/ECS-320-8-47-CKM-TR3.step

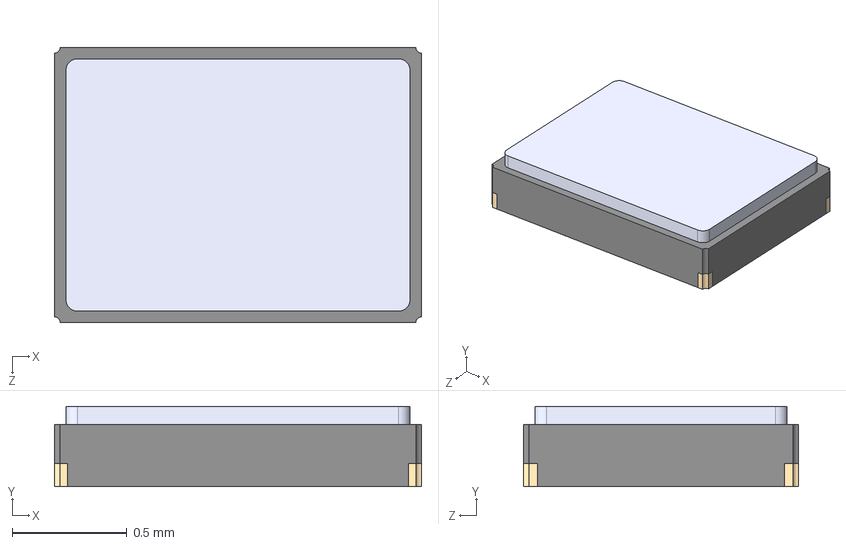
[picture p16: CAD file, 2025-03-27]
symbolsFootprints/ECS-320-8-47-CKM-TR3.step
1.60 x 0.35 x 1.20 mm
