Sinis16/Atlas/symbolsFootprints/NRF52833-QDAA-R7.step

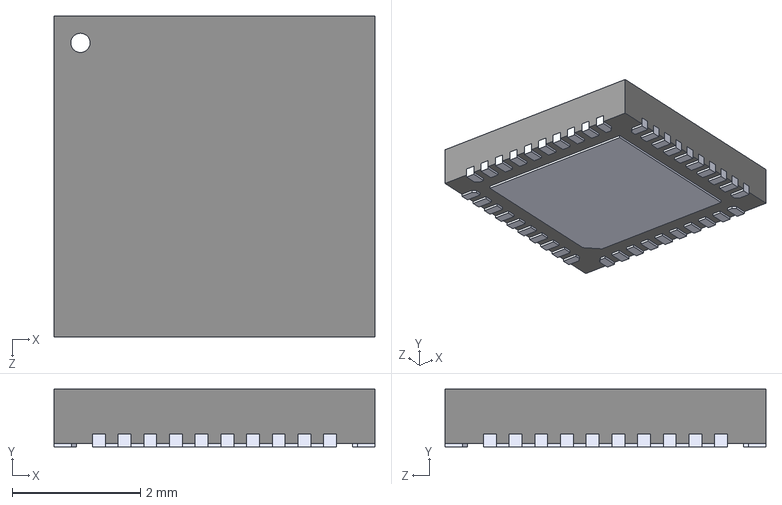
[picture p17: CAD file, 2025-03-27]
symbolsFootprints/NRF52833-QDAA-R7.step
5.00 x 0.9 x 5.00 mm
