Sinis16/Atlas/Aether/Aether.kicad_pcb

## KiCad design Aether/Aether.kicad_pcb (2025-03-31)

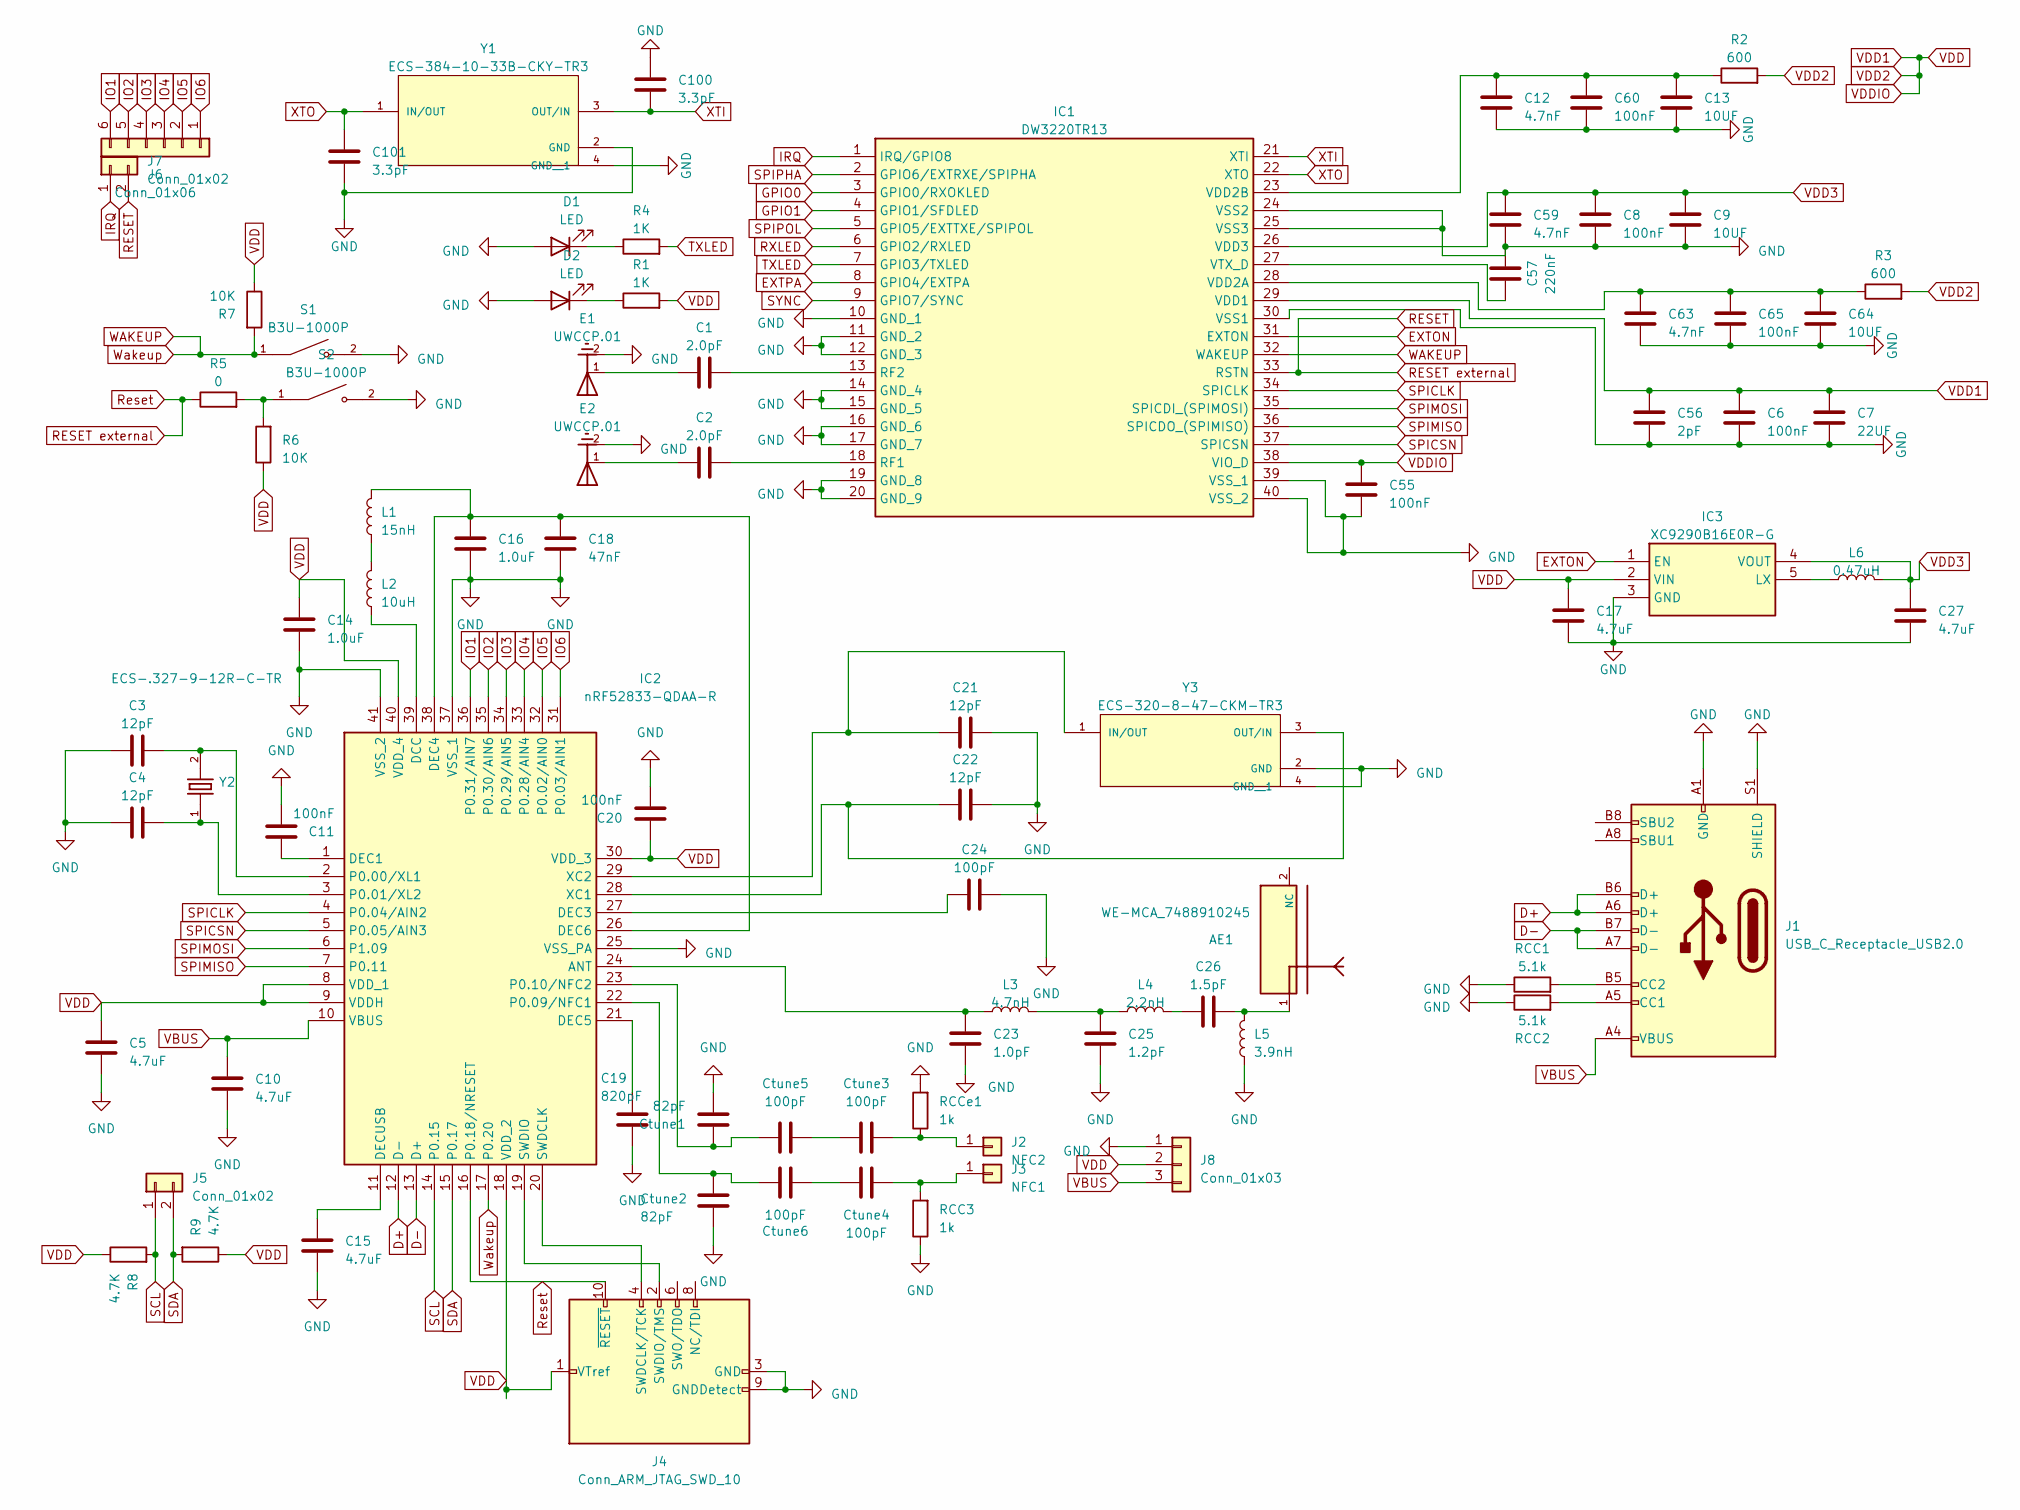
[picture p18: schematic Aether.kicad_sch]

Parts:
AE1: WE-MCA_7488910245; PART-NUMBER 7488910245
C1, C2: 2.0pF; C_0201_0603Metric
C3, C4, C21, C22: 12pF; C_0603_1608Metric
C5, C10, C15: 4.7uF; C_0603_1608Metric
C6, C8, C11, C20, C60, C65: 100nF; C_0603_1608Metric
C7: 22UF; C_0603_1608Metric
C9, C13, C64: 10UF; C_0603_1608Metric
C12, C59, C63: 4.7nF; C_0603_1608Metric
C14, C16: 1.0uF; C_0603_1608Metric
C17, C27: 4.7uF; C_0201_0603Metric_Pad0.64x0.40mm_HandSolder
C18: 47nF; C_0603_1608Metric
C19: 820pF; C_0603_1608Metric
C23: 1.0pF; C_0201_0603Metric_Pad0.64x0.40mm_HandSolder
C24: 100pF; C_0603_1608Metric
C25: 1.2pF; C_0201_0603Metric_Pad0.64x0.40mm_HandSolder
C26: 1.5pF; C_0201_0603Metric_Pad0.64x0.40mm_HandSolder
C55: 100nF; C_0402_1005Metric
C56: 2pF; C_0603_1608Metric
C57: 220nF; C_0603_1608Metric
C100, C101: 3.3pF; C_0603_1608Metric
Ctune1, Ctune2: 82pF; C_0603_1608Metric
Ctune3, Ctune4, Ctune5, Ctune6: 100pF; C_0805_2012Metric
D1, D2: LED; LED_0603_1608Metric
E1, E2: UWCCP.01; ANTENNA_UWCCP.01; PARTREV SPE-17-8-057/AZ
IC1: DW3220TR13; DW3220TR13-1; Manufacturer_Part_Number DW3220TR13; Mouser Part Number 772-DW3220TR13
IC2: nRF52833-QDAA-R; QFN40P500X500X90-41N; Manufacturer_Part_Number nRF52833-QDAA-R; Mouser Part Number 949-NRF52833-QDAA-R
IC3: XC9290B16E0R-G; XC9290A07E0RG; Manufacturer_Part_Number XC9290B16E0R-G; Mouser Part Number 865-XC9290B16E0R-G
J1: USB_C_Receptacle_USB2.0; USB_C_Receptacle_Palconn_UTC16-G
J2: NFC2; TestPoint_Pad_3.0x3.0mm
J3: NFC1; TestPoint_Pad_3.0x3.0mm
J4: Conn_ARM_JTAG_SWD_10; PinHeader_2x05_P1.27mm_Vertical
J5, J7: Conn_01x02; PinHeader_1x02_P2.54mm_Vertical
J6: Conn_01x06; PinHeader_1x06_P2.54mm_Vertical
J8: Conn_01x03; PinHeader_1x03_P2.54mm_Vertical
L1: 15nH; L_0603_1608Metric
L2: 10uH; L_0603_1608Metric
L3: 4.7nH; L_0201_0603Metric
L4: 2.2nH; L_0201_0603Metric
L5: 3.9nH; L_0201_0603Metric
L6: 0.47uH; L_01005_0402Metric
R1, R4: 1K; R_0603_1608Metric_Pad0.98x0.95mm_HandSolder
R2, R3: 600; R_0603_1608Metric_Pad0.98x0.95mm_HandSolder
R5: 0; R_0603_1608Metric_Pad0.98x0.95mm_HandSolder
R6, R7: 10K; R_0603_1608Metric_Pad0.98x0.95mm_HandSolder
R8, R9: 4.7K; R_0603_1608Metric_Pad0.98x0.95mm_HandSolder
RCC1, RCC2: 5.1k; R_0603_1608Metric
RCC3: 1k; R_0603_1608Metric
RCCe1: 1k; R_0603_1608Metric
S1, S2: B3U-1000P; SW_B3U-1000P
Y1: ECS-384-10-33B-CKY-TR3; XTAL_ECS-384-10-33B-CKY-TR3; PARTREV 2017
Y2: ECS-.327-9-12R-C-TR; XTAL_ECS-.327-9-12R-C-TR; PARTREV 2017
Y3: ECS-320-8-47-CKM-TR3; XTAL_ECS-320-8-47-CKM-TR3; PARTREV 2017

Connections:
D+: IC2.12 (D-), J1.A6 (D+), J1.B6 (D+)
D-: IC2.13 (D+), J1.A7 (D-), J1.B7 (D-)
EXTON: IC1.31 (EXTON), IC3.1 (EN)
EXTPA: IC1.8 (GPIO4/EXTPA)
GND: C3.2, C4.2, C5.2, C6.1, C7.1, C8.1, C9.1, C10.2, C11.2, C12.1, C13.1, C14.2, C15.2, C16.2, C17.1, C18.2, C19.2, C20.2, C21.2, C22.2, C23.2, C24.2, C25.2, C27.1, C55.1, C56.1, C57.2, C59.1, C60.2, C63.1, C64.1, C65.1, C100.2, C101.1, Ctune1.2, Ctune2.2, D1.2 (A), D2.2 (A), E1.2, E2.2, IC1.10 (GND_1), IC1.11 (GND_2), IC1.12 (GND_3), IC1.14 (GND_4), IC1.15 (GND_5), IC1.16 (GND_6), IC1.17 (GND_7), IC1.19 (GND_8), IC1.20 (GND_9), IC1.24 (VSS2), IC1.25 (VSS3), IC1.30 (VSS1), IC1.39 (VSS_1), IC1.40 (VSS_2), IC2.25 (VSS_PA), IC2.37 (VSS_1), IC2.41 (VSS_2), IC3.3 (GND), J1.A1 (GND), J1.A12 (GND), J1.B1 (GND), J1.B12 (GND), J1.S1 (SHIELD), J4.3 (GND), J4.5 (GND), J4.9 (GNDDetect), J8.1, L5.1, RCC1.1, RCC2.1, RCC3.1, RCCe1.2, S1.2, S2.2, Y1.2 (GND), Y1.4 (GND__1), Y3.2 (GND), Y3.4 (GND__1)
GPIO0: IC1.3 (GPIO0/RXOKLED)
GPIO1: IC1.4 (GPIO1/SFDLED)
IO1: IC2.36 (P0.31/AIN7), J6.6
IO2: IC2.35 (P0.30/AIN6), J6.5
IO3: IC2.34 (P0.29/AIN5), J6.4
IO4: IC2.33 (P0.28/AIN4), J6.3
IO5: IC2.32 (P0.02/AIN0), J6.2
IO6: IC2.31 (P0.03/AIN1), J6.1
IRQ: IC1.1 (IRQ/GPIO8), J7.1
unnamed: AE1.1, C26.1, L5.2
unnamed: C1.2, E1.1
unnamed: C2.2, E2.1
unnamed: C25.1, L3.2, L4.1
unnamed: C26.2, L4.2
unnamed: Ctune3.2, Ctune5.1
unnamed: Ctune4.2, Ctune6.1
unnamed: D1.1 (K), R4.1
unnamed: D2.1 (K), R1.1
unnamed: C2.1, IC1.18 (RF1)
unnamed: C1.1, IC1.13 (RF2)
unnamed: C63.2, C64.2, C65.2, IC1.28 (VDD2A), R3.1
unnamed: C12.2, C13.2, C60.1, IC1.23 (VDD2B), R2.1
unnamed: C57.1, IC1.27 (VTX_D)
unnamed: C23.1, IC2.24 (ANT), L3.1
unnamed: IC2.39 (DCC), L2.1
unnamed: C11.1, IC2.1 (DEC1)
unnamed: C24.1, IC2.27 (DEC3)
unnamed: C16.1, C18.1, IC2.26 (DEC6), IC2.38 (DEC4), L1.2
unnamed: C19.1, IC2.21 (DEC5)
unnamed: C15.1, IC2.11 (DECUSB)
unnamed: C3.1, IC2.2 (P0.00/XL1), Y2.2
unnamed: C4.1, IC2.3 (P0.01/XL2), Y2.1
unnamed: Ctune2.1, Ctune6.2, IC2.22 (P0.09/NFC1)
unnamed: Ctune1.1, Ctune5.2, IC2.23 (P0.10/NFC2)
unnamed: IC2.20 (SWDCLK), J4.4 (SWDCLK/TCK)
unnamed: IC2.19 (SWDIO), J4.2 (SWDIO/TMS)
unnamed: C22.1, IC2.28 (XC1), Y3.3 (OUT/IN)
unnamed: C21.1, IC2.29 (XC2), Y3.1 (IN/OUT)
unnamed: IC3.5 (LX), L6.1
unnamed: J1.A5 (CC1), RCC2.2
unnamed: J1.B5 (CC2), RCC1.2
unnamed: Ctune3.1, J2.1, RCCe1.1
unnamed: Ctune4.1, J3.1, RCC3.2
unnamed: L1.1, L2.2
unnamed: R5.2, R6.2, S2.1
RESET: IC1.33 (RSTN), IC2.16 (P0.18/NRESET), J4.10 (~RESET), J7.2, R5.1
RXLED: IC1.6 (GPIO2/RXLED)
SCL: IC2.14 (P0.15), J5.1, R8.2
SDA: IC2.15 (P0.17), J5.2, R9.2
SPICLK: IC1.34 (SPICLK), IC2.4 (P0.04/AIN2)
SPICSN: IC1.37 (SPICSN), IC2.5 (P0.05/AIN3)
SPIMISO: IC1.36 (SPICDO_(SPIMISO)), IC2.7 (P0.11)
SPIMOSI: IC1.35 (SPICDI_(SPIMOSI)), IC2.6 (P1.09)
SPIPHA: IC1.2 (GPIO6/EXTRXE/SPIPHA)
SPIPOL: IC1.5 (GPIO5/EXTTXE/SPIPOL)
SYNC: IC1.9 (GPIO7/SYNC)
TXLED: IC1.7 (GPIO3/TXLED), R4.2
VBUS: C10.1, IC2.10 (VBUS), J1.A4 (VBUS), J1.A9 (VBUS), J1.B4 (VBUS), J1.B9 (VBUS), J8.3
VDD: C5.1, C6.2, C7.2, C14.1, C17.2, C20.1, C55.2, C56.2, IC1.29 (VDD1), IC1.38 (VIO_D), IC2.8 (VDD_1), IC2.9 (VDDH), IC2.18 (VDD_2), IC2.30 (VDD_3), IC2.40 (VDD_4), IC3.2 (VIN), J4.1 (VTref), J8.2, R1.2, R2.2, R3.2, R6.1, R7.1, R8.1, R9.1
VDD3: C8.2, C9.2, C27.2, C59.2, IC1.26 (VDD3), IC3.4 (VOUT), L6.2
WAKEUP: IC1.32 (WAKEUP), IC2.17 (P0.20), R7.2, S1.1
XTI: C100.1, IC1.21 (XTI), Y1.3 (OUT/IN)
XTO: C101.2, IC1.22 (XTO), Y1.1 (IN/OUT)

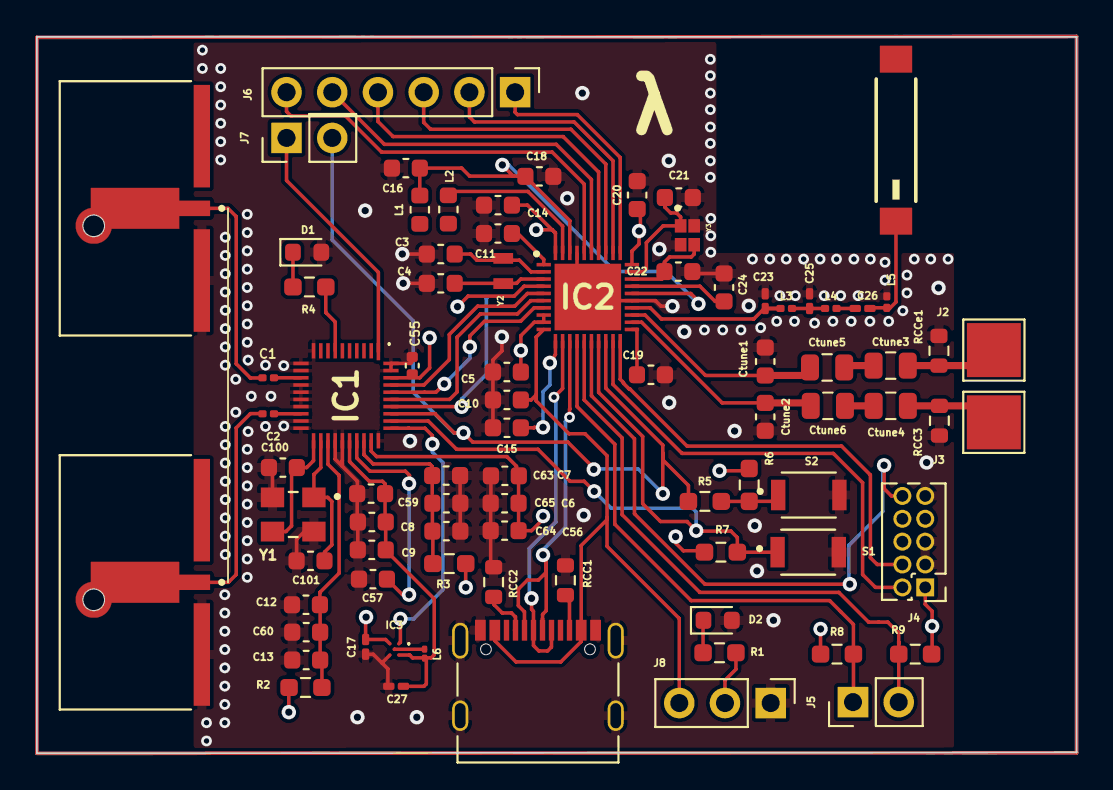
[picture p19: board Aether.kicad_pcb from above]

Board: 4 copper layers, 57.8 x 39.8 mm, 83 parts (0 on the bottom side), 61 nets.
