Sinis16/Atlas/nPM1100v2/nPM1100v2.kicad_pcb

## KiCad design nPM1100v2/nPM1100v2.kicad_pcb (2025-03-27)

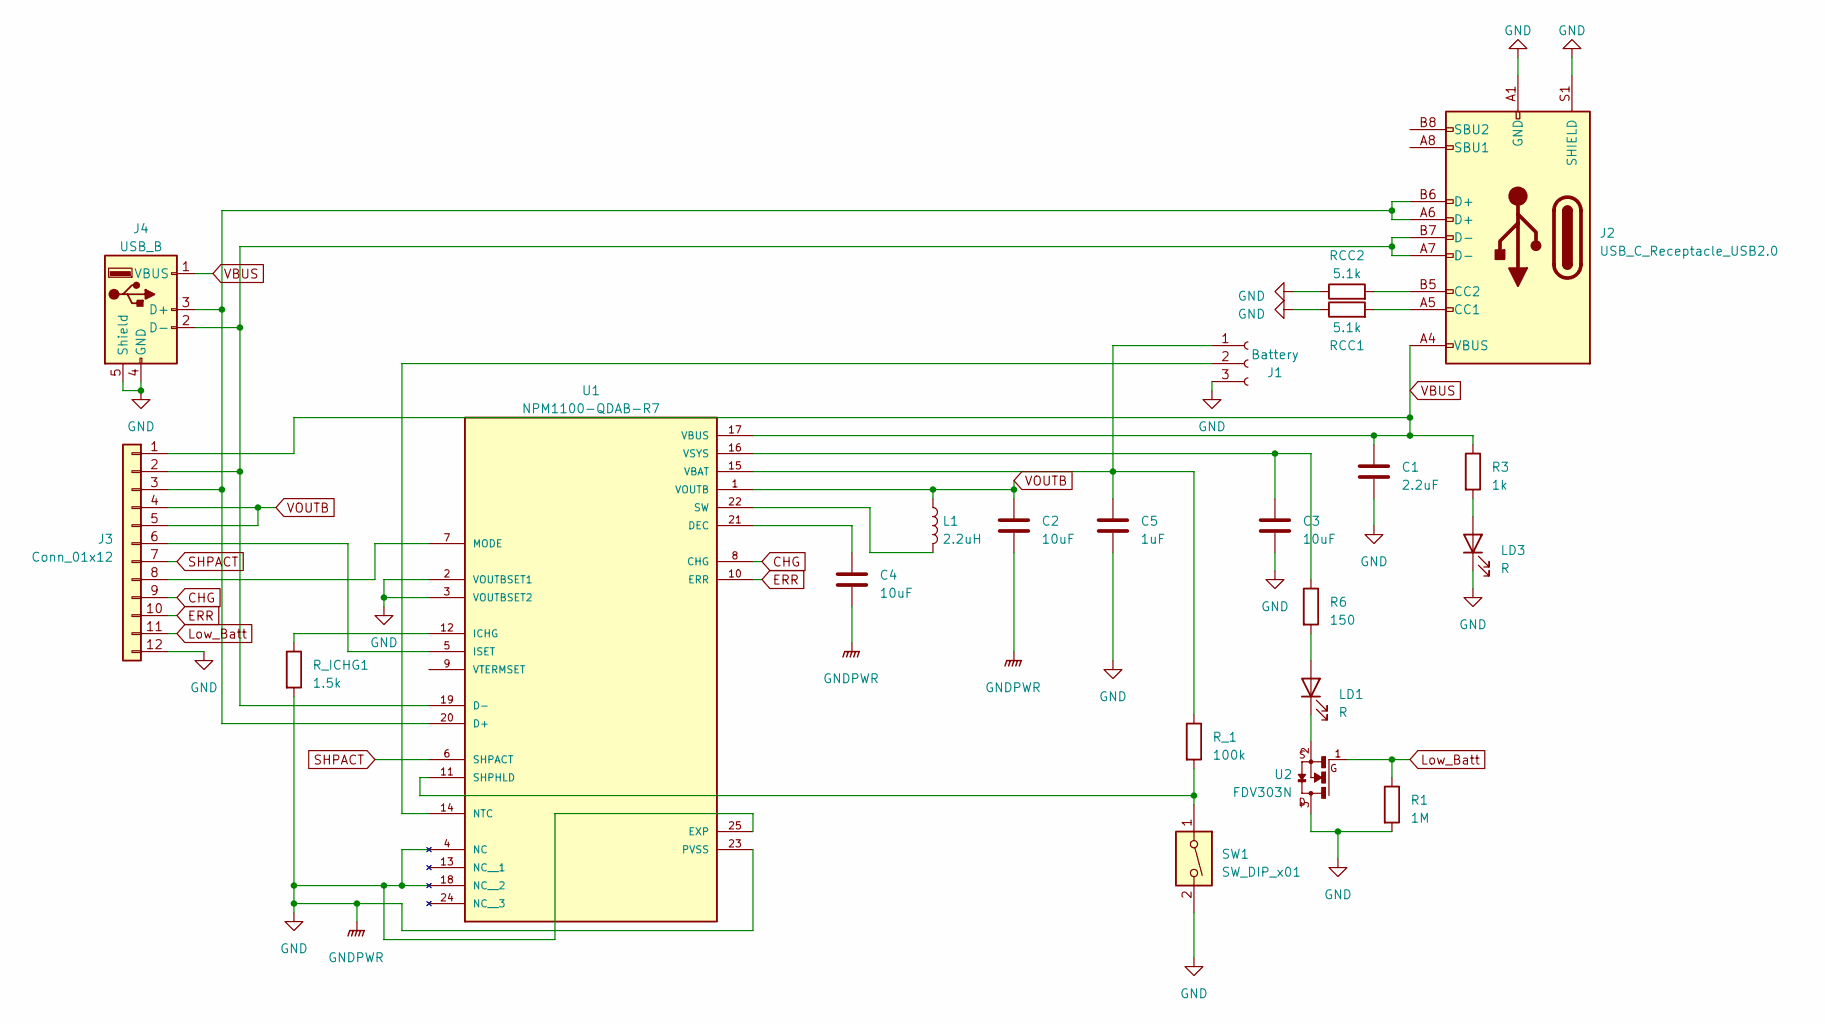
[picture p20: schematic nPM1100v2.kicad_sch]

Parts:
C1: 2.2uF; C_0603_1608Metric
C2, C3, C4: 10uF; C_0603_1608Metric
C5: 1uF; C_0603_1608Metric
J1: Battery; JST_XH_B3B-XH-A_1x03_P2.50mm_Vertical
J2: USB_C_Receptacle_USB2.0; USB_C_Receptacle_Palconn_UTC16-G
J3: Conn_01x12; PinHeader_1x12_P2.54mm_Vertical
J4: USB_B; USB_A_TE_292303-7_Horizontal
L1: 2.2uH; L_0805_2012Metric
LD1, LD3: R; LED_0201_0603Metric
R1: 1M; R_0201_0603Metric
R3: 1k; R_0201_0603Metric
R6: 150; R_0201_0603Metric
RCC1, RCC2: 5.1k; R_0201_0603Metric
R_1: 100k; R_0201_0603Metric
R_ICHG1: 1.5k; R_0201_0603Metric
SW1: SW_DIP_x01; SW_B3U-1000P
U1: NPM1100-QDAB-R7; QFN50P400X400X90-25N; PARTREV 1.3
U2: FDV303N; SOT23

Connections:
CHG: J3.9, U1.8 (CHG)
ERR: J3.10, U1.10 (ERR)
GND: C1.2, C2.2, C3.2, C4.2, C5.2, J1.3, J2.A1 (GND), J2.A12 (GND), J2.B1 (GND), J2.B12 (GND), J2.S1 (SHIELD), J3.12, J4.4 (GND), J4.5 (Shield), LD3.1 (K), R1.2, RCC1.1, RCC2.1, R_ICHG1.2, SW1.2, U1.2 (VOUTBSET1), U1.3 (VOUTBSET2), U1.4 (NC), U1.18 (NC__2), U1.23 (PVSS), U1.25 (EXP), U2.3
Low_Batt: J3.11, R1.1, U2.1
unnamed: C5.1, J1.1, R_1.1, U1.15 (VBAT)
unnamed: J1.2, U1.14 (NTC)
unnamed: J2.A5 (CC1), RCC1.2
unnamed: J2.B5 (CC2), RCC2.2
unnamed: J2.A7 (D-), J2.B7 (D-), J3.2, J4.2 (D-), U1.19 (D-)
unnamed: J2.A6 (D+), J2.B6 (D+), J3.3, J4.3 (D+), U1.20 (D+)
unnamed: J3.6, U1.5 (ISET)
unnamed: J3.8, U1.7 (MODE)
unnamed: LD1.2 (A), R6.2
unnamed: LD1.1 (K), U2.2
unnamed: LD3.2 (A), R3.2
unnamed: C4.1, U1.21 (DEC)
unnamed: R_ICHG1.1, U1.12 (ICHG)
unnamed: R_1.2, SW1.1, U1.11 (SHPHLD)
unnamed: L1.2, U1.22 (SW)
unnamed: C3.1, R6.1, U1.16 (VSYS)
SHPACT: J3.7, U1.6 (SHPACT)
VBUS: C1.1, J2.A4 (VBUS), J2.A9 (VBUS), J2.B4 (VBUS), J2.B9 (VBUS), J3.1, J4.1 (VBUS), R3.1, U1.17 (VBUS)
VOUTB: C2.1, J3.4, J3.5, L1.1, U1.1 (VOUTB)

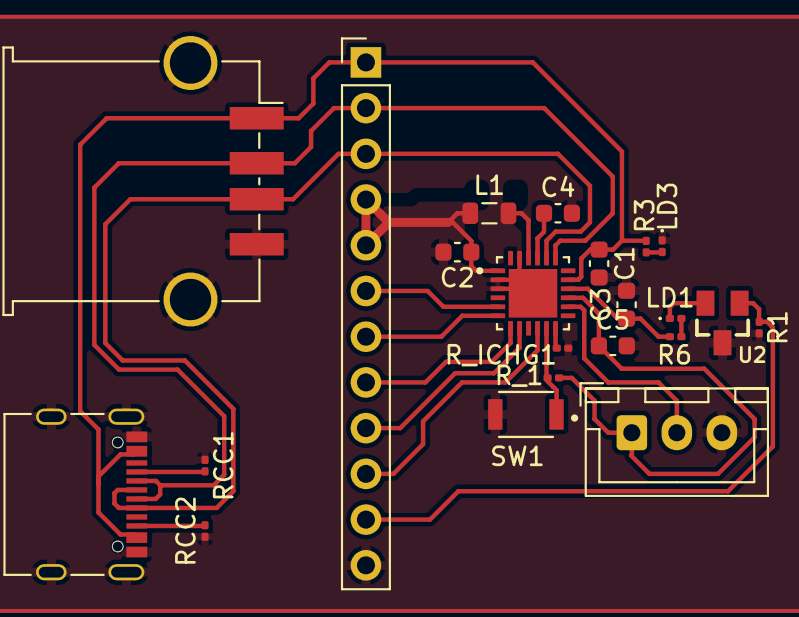
[picture p21: board nPM1100v2.kicad_pcb from above]

Board: 2 copper layers, 22 parts (0 on the bottom side), 23 nets.
