Sinis16/Atlas/3BQ5101eBRHLR/3BQ5101eBRHLR.kicad_pcb

## KiCad design 3BQ5101eBRHLR/3BQ5101eBRHLR.kicad_pcb (2025-03-27)

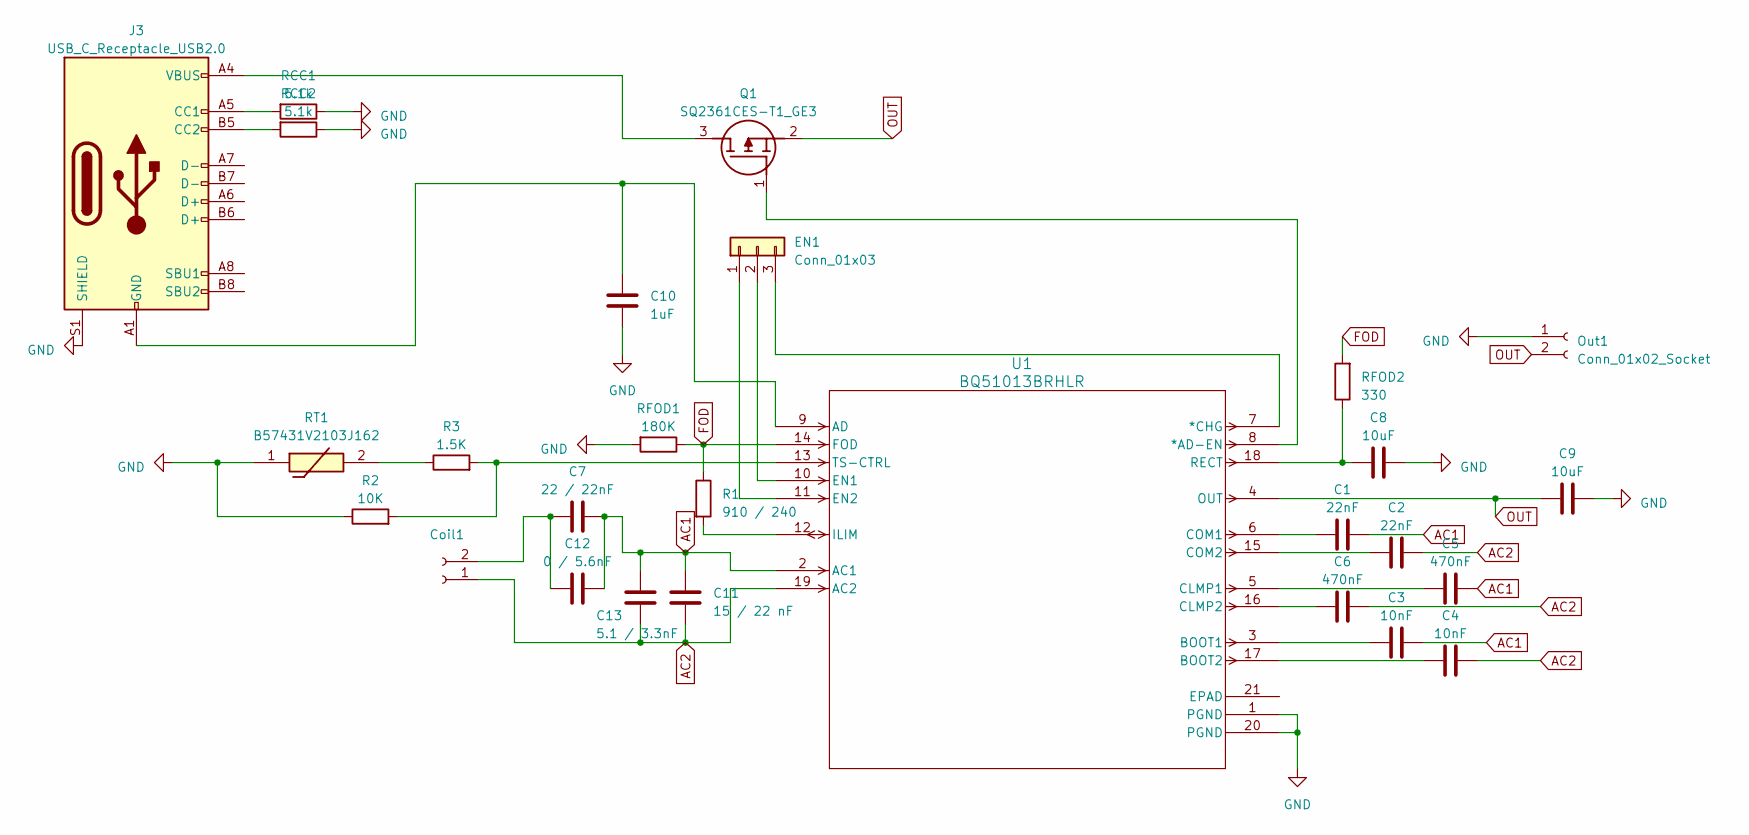
[picture p22: schematic 3BQ5101eBRHLR.kicad_sch]

Parts:
C1, C2: 22nF; C_0603_1608Metric
C3, C4: 10nF; C_0603_1608Metric
C5, C6: 470nF; C_0603_1608Metric
C7: 22 / 22nF; C_0603_1608Metric
C8, C9: 10uF; C_0603_1608Metric
C10: 1uF; C_0603_1608Metric
C11: 15 / 22 nF; C_0603_1608Metric
C12: 0 / 5.6nF; C_0603_1608Metric
C13: 5.1 / 3.3nF; C_0603_1608Metric
Coil1: TerminalBlock_bornier-2_P5.08mm
EN1: Conn_01x03; PinSocket_1x03_P2.54mm_Vertical
J3: USB_C_Receptacle_USB2.0; USB_C_Receptacle_Palconn_UTC16-G
Out1: Conn_01x02_Socket; PinSocket_1x02_P2.54mm_Vertical
Q1: SQ2361CES-T1_GE3; SOT95P237X112-3N; Mouser Part Number 78-SQ2361CES-T1_GE3
R1: 910 / 240; R_0603_1608Metric
R2: 10K; R_0603_1608Metric
R3: 1.5K; R_0603_1608Metric
RCC1, RCC2: 5.1k; R_0603_1608Metric
RFOD1: 180K; R_0603_1608Metric
RFOD2: 330; R_0603_1608Metric
RT1: B57431V2103J162; THRMC2012X50N; Manufacturer_Part_Number NTC0805J2K0; Mouser Part Number 279-NTC0805J2K0
U1: BQ51013BRHLR; BQ5101eBRHLR

Connections:
AC1: C1.2, C3.2, C5.2, C7.2, C11.2, C12.2, C13.2, U1.2 (AC1)
AC2: C2.2, C4.2, C6.2, C11.1, C13.1, Coil1.1, U1.19 (AC2)
FOD: R1.1, RFOD1.1, RFOD2.2, U1.14 (FOD)
GND: C8.2, C9.2, C10.1, J3.S1 (SHIELD), Out1.1, R2.1, RCC1.1, RCC2.1, RFOD1.2, RT1.1, U1.1 (PGND), U1.20 (PGND)
unnamed: C7.1, C12.1, Coil1.2
unnamed: EN1.1, U1.11 (EN2)
unnamed: EN1.2, U1.10 (EN1)
unnamed: EN1.3, U1.7 (*CHG)
unnamed: J3.A5 (CC1), RCC1.2
unnamed: J3.B5 (CC2), RCC2.2
unnamed: J3.A4 (VBUS), J3.A9 (VBUS), J3.B4 (VBUS), J3.B9 (VBUS), Q1.3 (D)
unnamed: Q1.1 (G), U1.8 (*AD-EN)
unnamed: R3.1, RT1.2
unnamed: C10.2, J3.A1 (GND), J3.A12 (GND), J3.B1 (GND), J3.B12 (GND), U1.9 (AD)
unnamed: C3.1, U1.3 (BOOT1)
unnamed: C4.1, U1.17 (BOOT2)
unnamed: C5.1, U1.5 (CLMP1)
unnamed: C6.1, U1.16 (CLMP2)
unnamed: C1.1, U1.6 (COM1)
unnamed: C2.1, U1.15 (COM2)
unnamed: R1.2, U1.12 (ILIM)
unnamed: C8.1, RFOD2.1, U1.18 (RECT)
unnamed: R2.2, R3.2, U1.13 (TS-CTRL)
OUT: C9.1, Out1.2, Q1.2 (S), U1.4 (OUT)

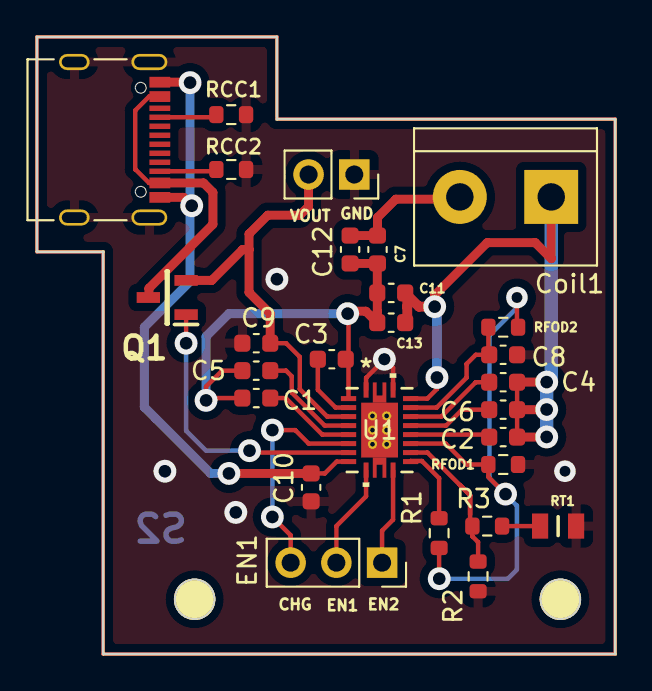
[picture p23: board 3BQ5101eBRHLR.kicad_pcb from above]

Board: 2 copper layers, 32.1 x 34.3 mm, 27 parts (0 on the bottom side), 24 nets.
