Sinis16/Atlas/2PAM8904/2PAM8904.kicad_pcb

## KiCad design 2PAM8904/2PAM8904.kicad_pcb (2025-03-27)

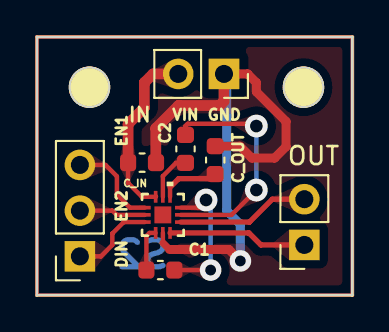
[picture p24: board 2PAM8904.kicad_pcb from above]

Board: 2 copper layers, 17.5 x 14.4 mm, 8 parts (0 on the bottom side), 12 nets.

Parts:
C1, C2: 1uF; C_0603_1608Metric
C_IN: 2.2uF; C_0603_1608Metric
C_OUT: 2.2uF; C_0603_1608Metric
EN1: Conn_01x02_Socket; PinSocket_1x03_P2.54mm_Vertical
IN: Conn_01x03_Socket; PinSocket_1x02_P2.54mm_Vertical
OUT: Conn_01x02_Socket; PinSocket_1x02_P2.54mm_Vertical
PAM8904EGPR1: QFN-12_PAM8904EGPR_DIO

Connections:
GND: C_IN.2, C_OUT.2, IN.1, PAM8904EGPR1.5 (GND)
unnamed: EN1.1, PAM8904EGPR1.3 (DIN)
unnamed: EN1.2, PAM8904EGPR1.2 (EN2)
unnamed: EN1.3, PAM8904EGPR1.1 (EN1)
unnamed: C_IN.1, IN.2, PAM8904EGPR1.12 (VIN)
unnamed: OUT.1, PAM8904EGPR1.6 (VO2)
unnamed: OUT.2, PAM8904EGPR1.7 (VO1)
unnamed: C1.1, PAM8904EGPR1.4 (CN1)
unnamed: C2.1, PAM8904EGPR1.8 (CN2)
unnamed: C1.2, PAM8904EGPR1.9 (CP1)
unnamed: C2.2, PAM8904EGPR1.11 (CP2)
unnamed: C_OUT.1, PAM8904EGPR1.10 (VOUT)
