Sinis16/Atlas/nRF52833/nRF52833.kicad_pcb

## KiCad design nRF52833/nRF52833.kicad_pcb (2025-03-27)

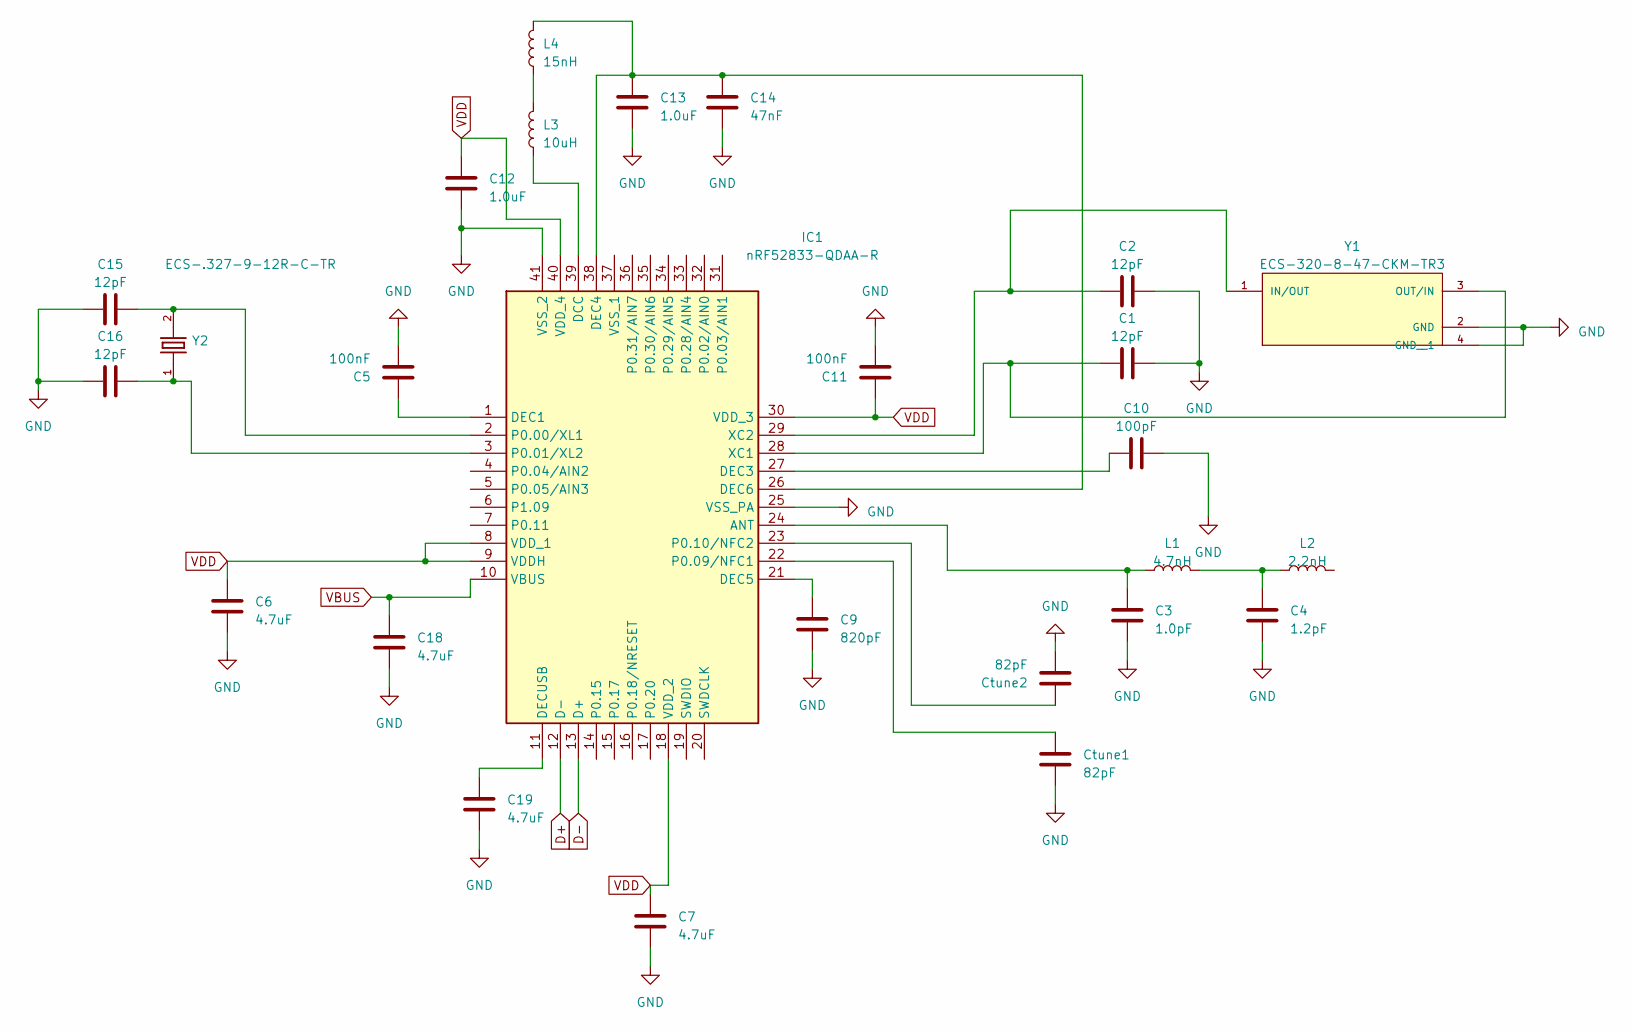
[picture p25: schematic nRF52833.kicad_sch]

Parts:
C1, C2, C15, C16: 12pF; C_0603_1608Metric
C3: 1.0pF; C_0603_1608Metric
C4: 1.2pF; C_0603_1608Metric
C5, C11: 100nF; C_0603_1608Metric
C6, C7, C18, C19: 4.7uF; C_0603_1608Metric
C9: 820pF; C_0603_1608Metric
C10: 100pF; C_0603_1608Metric
C12, C13: 1.0uF; C_0603_1608Metric
C14: 47nF; C_0603_1608Metric
Ctune1, Ctune2: 82pF; C_0603_1608Metric
IC1: nRF52833-QDAA-R; QFN40P500X500X90-41N; Manufacturer_Part_Number nRF52833-QDAA-R; Mouser Part Number 949-NRF52833-QDAA-R
L1: 4.7nH; L_0603_1608Metric
L2: 2.2nH; L_0603_1608Metric
L3: 10uH; L_0603_1608Metric
L4: 15nH; L_0603_1608Metric
Y1: ECS-320-8-47-CKM-TR3; XTAL_ECS-320-8-47-CKM-TR3; PARTREV 2017
Y2: ECS-.327-9-12R-C-TR; XTAL_ECS-.327-9-12R-C-TR; PARTREV 2017

Connections:
D+: IC1.12 (D-)
D-: IC1.13 (D+)
GND: C1.2, C2.2, C3.2, C4.2, C5.2, C6.2, C7.2, C9.2, C10.2, C11.2, C12.2, C13.2, C14.2, C15.2, C16.2, C18.2, C19.2, Ctune1.2, Ctune2.2, IC1.25 (VSS_PA), IC1.41 (VSS_2), Y1.2 (GND), Y1.4 (GND__1)
unnamed: C4.1, L1.2, L2.1
unnamed: C3.1, IC1.24 (ANT), L1.1
unnamed: IC1.39 (DCC), L3.1
unnamed: C5.1, IC1.1 (DEC1)
unnamed: C10.1, IC1.27 (DEC3)
unnamed: C13.1, C14.1, IC1.26 (DEC6), IC1.38 (DEC4), L4.2
unnamed: C9.1, IC1.21 (DEC5)
unnamed: C19.1, IC1.11 (DECUSB)
unnamed: C15.1, IC1.2 (P0.00/XL1), Y2.2
unnamed: C16.1, IC1.3 (P0.01/XL2), Y2.1
unnamed: Ctune1.1, IC1.22 (P0.09/NFC1)
unnamed: Ctune2.1, IC1.23 (P0.10/NFC2)
unnamed: C1.1, IC1.28 (XC1), Y1.3 (OUT/IN)
unnamed: C2.1, IC1.29 (XC2), Y1.1 (IN/OUT)
unnamed: L3.2, L4.1
VBUS: C18.1, IC1.10 (VBUS)
VDD: C6.1, C7.1, C11.1, C12.1, IC1.8 (VDD_1), IC1.9 (VDDH), IC1.18 (VDD_2), IC1.30 (VDD_3), IC1.40 (VDD_4)

Board: 2 copper layers, 26 parts (0 on the bottom side), 18 nets, no tracks yet.
