Sinis16/Atlas/BMA400/BMA400.kicad_pcb

## KiCad design BMA400/BMA400.kicad_pcb (2025-03-27)

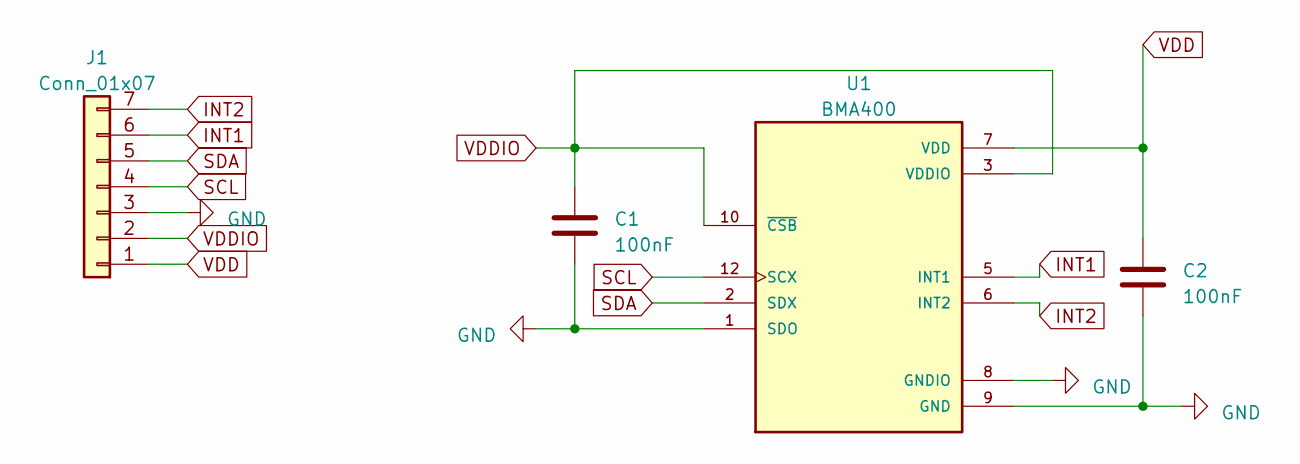
[picture p26: schematic BMA400.kicad_sch]

Parts:
C1, C2: 100nF; C_0603_1608Metric
J1: Conn_01x07; PinSocket_1x07_P2.54mm_Vertical
U1: BMA400; XDCR_BMA400

Connections:
GND: C1.2, C2.2, J1.3, U1.1 (SDO), U1.8 (GNDIO), U1.9 (GND)
INT1: J1.6, U1.5 (INT1)
INT2: J1.7, U1.6 (INT2)
SCL: J1.4, U1.12 (SCX)
SDA: J1.5, U1.2 (SDX)
VDD: C2.1, J1.1, U1.7 (VDD)
VDDIO: C1.1, J1.2, U1.3 (VDDIO), U1.10 (~CSB)

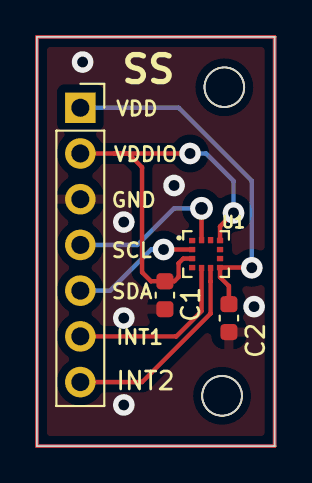
[picture p27: board BMA400.kicad_pcb from above]

Board: 2 copper layers, 13.2 x 22.7 mm, 4 parts (0 on the bottom side), 7 nets.
